dokee39/Aokee-sim/webots/worlds/.balance_infantry_test.jpg

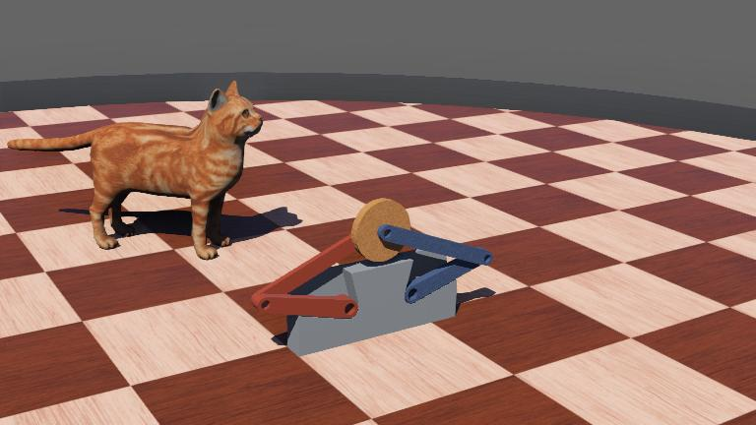
webots/worlds/.balance_infantry_test.jpg
