dokee39/Aokee-sim/webots/worlds/.five_link_sim.jpg

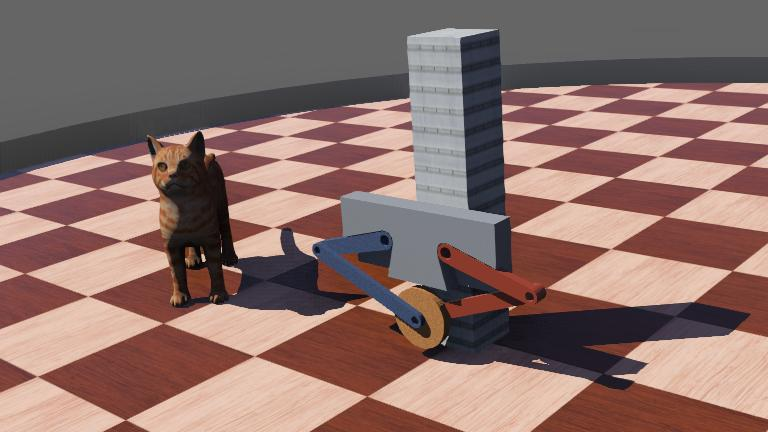
webots/worlds/.five_link_sim.jpg
