dokee39/Aokee-sim/README.md

# Aokee-sim

## 先完成, 再完美
## 先完成, 再完美
## 先完成, 再完美
## 先完成, 再完美
## 先完成, 再完美
## 先完成, 再完美
## 先完成, 再完美
## 先完成, 再完美
## 先完成, 再完美
## 先完成, 再完美
## 先完成, 再完美
## 先完成, 再完美
## 先完成, 再完美
## 先完成, 再完美
## 先完成, 再完美
## 先完成, 再完美
## 先完成, 再完美
## 先完成, 再完美
## 先完成, 再完美
## 先完成, 再完美
## 先完成, 再完美
## 先完成, 再完美
## 先完成, 再完美
## 先完成, 再完美
## 先完成, 再完美
## 先完成, 再完美
## 先完成, 再完美
## 先完成, 再完美
## 先完成, 再完美
## 先完成, 再完美
## 先完成, 再完美
## 先完成, 再完美
## 先完成, 再完美
## 先完成, 再完美
## 先完成, 再完美
## 先完成, 再完美
## 先完成, 再完美
## 先完成, 再完美
## 先完成, 再完美
## 先完成, 再完美
## 先完成, 再完美
## 先完成, 再完美
## 先完成, 再完美
## 先完成, 再完美
## 先完成, 再完美
## 先完成, 再完美
## 先完成, 再完美
## 先完成, 再完美
## 先完成, 再完美
## 先完成, 再完美
## 先完成, 再完美
## 先完成, 再完美
## 先完成, 再完美
## 先完成, 再完美
## 先完成, 再完美
## 先完成, 再完美
## 先完成, 再完美
## 先完成, 再完美
## 先完成, 再完美
