dokee39/Aokee-sim/webots/worlds/.lqr_sim.jpg

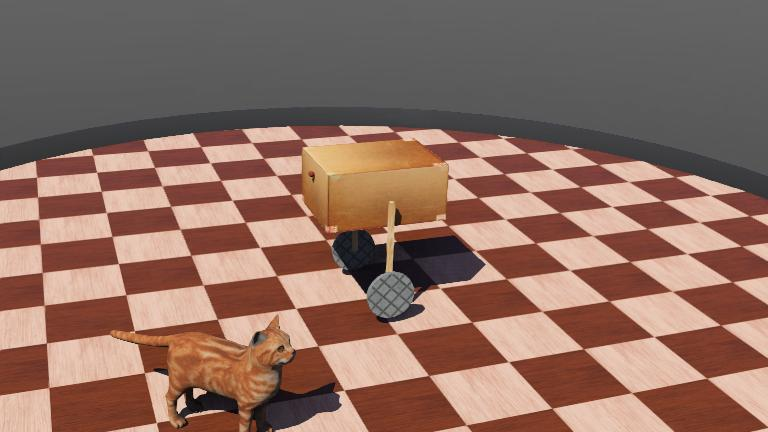
webots/worlds/.lqr_sim.jpg
