dokee39/Aokee-sim/model/Aokee BOM.xlsx

级别 | 零件名称 | 数量 | 总数 | 单价 | 总价 | 已出图 | 已加工/采购
1.1.1.3 | ###__front_rear_end | 2
1.1.1.4 | ###__joint | 2
1.1.3 | ##__bottom | 1
1.1.1 | ##__frame | 1
1.1.2 | ##__leg | 2
1.1.1.4.12 | CNC_A96061__frame_纵竖连接 | 2 | 4 | 17.6 | 70.4 | TRUE | TRUE
1.1.2.17 | CNC_A96061__joint_不带螺纹 | 2 | 4 | 15.6 | 62.4 | FALSE | FALSE
1.1.2.13 | CNC_A96061__joint_带螺纹 | 2 | 4 | 15.6 | 62.4 | TRUE | FALSE
1.1.2.19 | CNC_A96061__wheel_jonit | 1 | 2 | 15.6 | 31.2 | FALSE | FALSE
1.1.1.4.13 | CNC_A96061__关节电机固定1 | 1 | 2 | 25.6 | 51.2 | TRUE | FALSE
1.1.1.4.14 | CNC_A96061__关节电机固定2 | 1 | 2 | 25.6 | 51.2 | TRUE | FALSE
1.1.2.23 | CNC_A96061__轮毂 | 1 | 2 | 54.6 | 109.2 | TRUE | FALSE
1.1.3.5 | CNC_A96061__铝方管与肚兜前板连接件 | 2 | 2 | 15.6 | 31.2 | TRUE | TRUE
1.1.3.7 | CNC_A96061__铝方管与阻尼合页连接件 | 2 | 2 | 15.6 | 31.2 | TRUE | TRUE
1.1.1.3.1 | CNC_A96061__前后挡板连接件 | 2 | 4 | 15.6 | 62.4 | TRUE | FALSE
1.1.1.4.5 | CNC_A96061__碳管管夹座 | 4 | 8 | 15.6 | 124.8 | TRUE | 4
1.1.1.4.1 | CNC_A96061__碳管管夹座 (不带螺纹) | 2 | 4 | 15.6 | 62.4 | TRUE | FALSE
1.1.3.3 | EE_COM__大疆电池 | 1 | 1
1.1.1.4.8 | EE_MOTOR__GO-M8010-6 | 1 | 2 | 490 | 980 |  | FALSE
1.1.2.12 | EE_MOTOR__GO-M8010-6 | 2 | 4 | 490 | 1960 |  | FALSE
1.1.1.3.11 | OTR_COM__弹簧合页 | 1 | 2 | 5.9 | 11.8 |  | TRUE
1.1.1.3.6 | OTR_COM__导轮_6*24*8 | 2 | 4 | 3.6 | 14.4 |  | TRUE
1.1.2.14 | OTR_COM__轮毂包胶 | 1 | 2 |  | 0 |  | FALSE
1.1.1.4.4 | OTR_COM__碳管管夹_20 | 12 | 24 | 4 | 96 |  | TRUE
1.1.3.1 | OTR_COM__阻尼合页 | 2 | 2 | 15 | 30 |  | TRUE
1.1.1.3.13 | PL_C1_盖子 | 1 | 2 |  | 0 | TRUE | FALSE
1.1.2.5 | PL_C10__joint_中间碳板 | 2 | 4 |  | 0 | TRUE | FALSE
1.1.2.22 | PL_C10__leg_lower1 | 1 | 2 |  | 0 | TRUE | FALSE
1.1.2.11 | PL_C10__leg_lower2 | 1 | 2 |  | 0 | TRUE | FALSE
1.1.2.7 | PL_C10__leg_upper1 | 2 | 4 |  | 0 | TRUE | FALSE
1.1.2.4 | PL_C10__wheel_偏移板 | 1 | 2 |  | 0 | TRUE | FALSE
1.1.1.4.11 | PL_C10__关节连接件_10 | 1 | 2 |  | 0 | TRUE | FALSE
1.1.1.4.2 | PL_C10__关节连接件_带限位 | 2 | 4 |  | 0 | TRUE | FALSE
1.1.2.3 | PL_C10__腿部限位连接件 | 1 | 2 |  | 0 | TRUE | FALSE
1.1.2.21 | PL_C2__wheel_joint | 1 | 2 |  | 0 | TRUE | FALSE
1.1.1.3.9 | PL_C2__导轮连接2 | 2 | 4 |  | 0 | TRUE | FALSE
1.1.3.11 | PL_C2__电池魔术贴钩板 | 1 | 1 |  | 0 | TRUE | FALSE
1.1.1.4.9 | PL_C2__关节连接件_2 | 1 | 2 |  | 0 | TRUE | FALSE
1.1.1.3.8 | PL_C3__导轮连接1 | 2 | 4 |  | 0 | TRUE | FALSE
1.1.1.3.14 | PL_C3__导轮转接板 | 2 | 4 |  | 0 | TRUE | FALSE
1.1.3.9 | PL_C3__肚兜侧板 | 2 | 2 |  | 0 | TRUE | FALSE
1.1.3.10 | PL_C3__肚兜底板 | 1 | 1 |  | 0 | TRUE | FALSE
1.1.3.8 | PL_C3__肚兜后板 | 1 | 1 |  | 0 | TRUE | FALSE
1.1.3.14 | PL_C3__肚兜前板 | 1 | 1 |  | 0 | TRUE | FALSE
1.1.1.3.2 | PL_C3__前后挡板 | 1 | 2 |  | 0 | TRUE | FALSE
1.1.1.4.15 | PL_C3__frame_joint_outer | 1 | 2 |  | 0 | TRUE | FALSE
1.1.2.8 | PL_C4__wheel_连接电机 | 1 | 2 |  | 0 | TRUE | FALSE
1.1.2.18 | PL_C4__wheel_连接轮毂 | 1 | 2 |  | 0 | TRUE | FALSE
1.1.1.3.16 | PL_C4__前后载板 | 1 | 2 |  | 0 | TRUE | FALSE
1.1.1.4.10 | PL_C5__frame_joint_inner | 1 | 2 |  | 0 | TRUE | FALSE
1.1.1.4.16 | PP_A3020_1__frame_joint_纵 | 1 | 2 |  | 0 | TRUE | FALSE
1.1.1.4.3 | PP_A3020_1_frame_joint_竖 | 2 | 4 |  | 0 | TRUE | FALSE
1.1.1.1 | PP_C20_1__碳纤维管 | 2 | 4 |  | 0 |  | FALSE
1.1.3.13 | PR_FDM_PLA__RFID连接件 | 1 | 1 |  | 0 | TRUE | TRUE
1.1.2.1 | PR_FDM_PLA__wheel_补差价垫板 | 1 | 2 |  | 0 | TRUE | TRUE
1.1.3.6 | PR_FDM_PLA__肚兜前板固定孔打印件 | 2 | 2 |  | 0 | TRUE | TRUE
1.1.1.3.15 | PR_FDM_PLA_装甲板底垫板 | 2 | 4 |  | 0 | TRUE | TRUE
1.1.1.4.6 | PR_FDM_PLA__板与纵铝方管间支撑件 | 3 | 6 |  | 0 | TRUE | TRUE
1.1.1.4.7 | PR_FDM_TPU__关节限位软块 | 2 | 4 |  | 0 | TRUE | FALSE
1.1.2.10 | PR_FDM_TPU__腿部限位柔性打印件 | 1 | 2 |  | 0 | TRUE | FALSE
1.1.2.9 | PR_FDM_TPU__蓄油环_joint | 2 | 4 |  | 0 | TRUE | FALSE
1.1.2.15 | PR_FDM_TPU__蓄油环_wheel | 1 | 2 |  | 0 | TRUE | FALSE
1.1.3.5.20 | PR_FDM_PLA__铝方管补强件1 | 1 | 2 |  | 0 | TRUE | TRUE
1.1.3.5.2 | PR_FDM_PLA__铝方管补强件2 | 4 | 8 |  | 0 | TRUE | TRUE
1.1.3.4 | PR_FDM_PLA__铝方管补强件3_1_带钩子 | 1 | 1 |  | 0 | TRUE | TRUE
1.1.3.6 | PR_FDM_PLA__铝方管补强件3_2_带钩子 | 1 | 1 |  | 0 | TRUE | TRUE
1.1.3.5.17 | PR_FDM_PLA__铝方管补强件4 | 1 | 2 |  | 0 | TRUE | TRUE
1.1.3.5.19 | PR_FDM_PLA__铝方管补强件5 | 2 | 4 |  | 0 | TRUE | TRUE
1.1.3.12 | RM__场地交互模块_FI02_2020 | 1 | 1 |  | 0
1.1.1.2 | RM__灯条模块_LI01_2020 | 1 | 2 |  | 0
1.1.3.4 | RM__电源模块_PM02_2020 | 1 | 1 |  | 0
1.1.1.3.12 | RM__装甲模块_AM12_2020 | 1 | 2 |  | 0
1.1.1.3.10 | RM__装甲支撑架A型_2020 | 2 | 4 |  | 0
1.1.2.6 | STD_BEAR__AXK2542_推力滚针_25*42*4 | 2 | 4 | 3 | 12 |  | TRUE
1.1.2.2 | STD_BEAR__AXK3552_推力滚针_35*52*4 | 1 | 2 | 2 | 4 |  | TRUE
1.1.2.20 | STD_BEAR__F6805ZZ_法兰_25*37*7 | 2 | 4 | 10 | 40 |  | TRUE
1.1.2.16 | STD_BEAR__F6806ZZ_法兰_30*42*7 | 1 | 2 | 6 | 12 |  | TRUE
1.1.1.3.5 | STD_COM__铝方条直角转接件_M4*16-H10*34 | 8 | 8 | 5.5 | 44 |  | TRUE
1.1.3.2 | STD_COM__铝方条直角转接件_M4*16-H10*34 | 4 | 8 | 5.5 | 44 |  | TRUE
1.1.1.3.4 | STD_FAST__垫圈_M6*10*1 | 4 | 8 |  | 0 |  | TRUE
1.1.1.3.7 | 六角螺母 DIN 934 - M5 x 0.8 钢 6 平垫圈 | 2 | 4 |  | 0 |  | TRUE
1.1.1.3.3 | 内六角头轴肩螺钉 ISO 7379 - 6 x 12 钢 4.6 平垫圈 | 2 | 4 |  | 0 |  | TRUE
