dokee39/Aokee-sim/motor/motor.xlsx

型号 | 额定扭矩 | 峰值扭矩 | 额定转速 | 峰值转速 | 额定电流 | 堵转电流 | 重量 | 减速比 | 齿轮类型 | 尺寸 | 价格 | 备注
SteadyWin GIM8108-8 | 7.5 | 22 | 110 | 320 | 7 | 25 | 396 | 8:1 | 金属 | 92x(24+11) | 599
SteadyWin GIM6108-8 | 5 | 11 | 120 | 420 | 10.5 | 25 | 388 | 8:1 | 金属 | 80x(26+10.5) | 449
小米 CyberGear | 4 | 12 | 240 | 296 | 6.5 | 23 | 317 | 7.75:1 | 塑料 | 80 | 549
本末 M1505B_111 | 3 | 9.5 | 360 | 510 | 7 | 30 | 1540 | 1:1 | - | 180x33 | 1200
瓴控 MF9025 V2 (16T) | 2.42 | 4.5 | 490 | 710 | 7.45 | 40 | 963 | 1:1 | - | 89x53 | 990
DJI M3508 减速箱改 | 2.46 | 3.69 | 571 | 587 | 10 | 2.5 | 336 | 268:17 | 金属 | 80x60 | 399
DJI M3508 | 3 | 4.5 | 469 | 482 | 10 | 2.5 | 365 | 3591:187 | 金属 | 42x67 | 0
小米铁蛋狗一代电机 |  | 32 |  | 220 |  | 40 | 560 |  |  | 93x54 | 300
Unitree GO-M8010-6 |  | 23.7 |  | 300 |  | 40 | 530 | 6.33:1 |  | 96x42 | 490
