dokee39/Aokee-sim/model/发加工/CNC/CNC_A96061__joint_不带螺纹.step

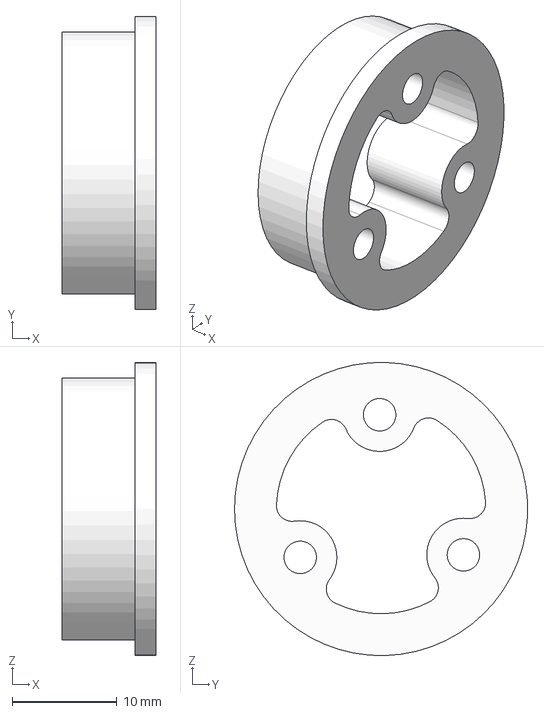
[picture p4: CAD file, 2024-09-26]
model/发加工/CNC/CNC_A96061__joint_不带螺纹.step
9.00 x 28.0 x 28.0 mm
