dokee39/Aokee-sim/model/发加工/PL/PL_C2__关节连接件_2_厚度2_数量2.dxf

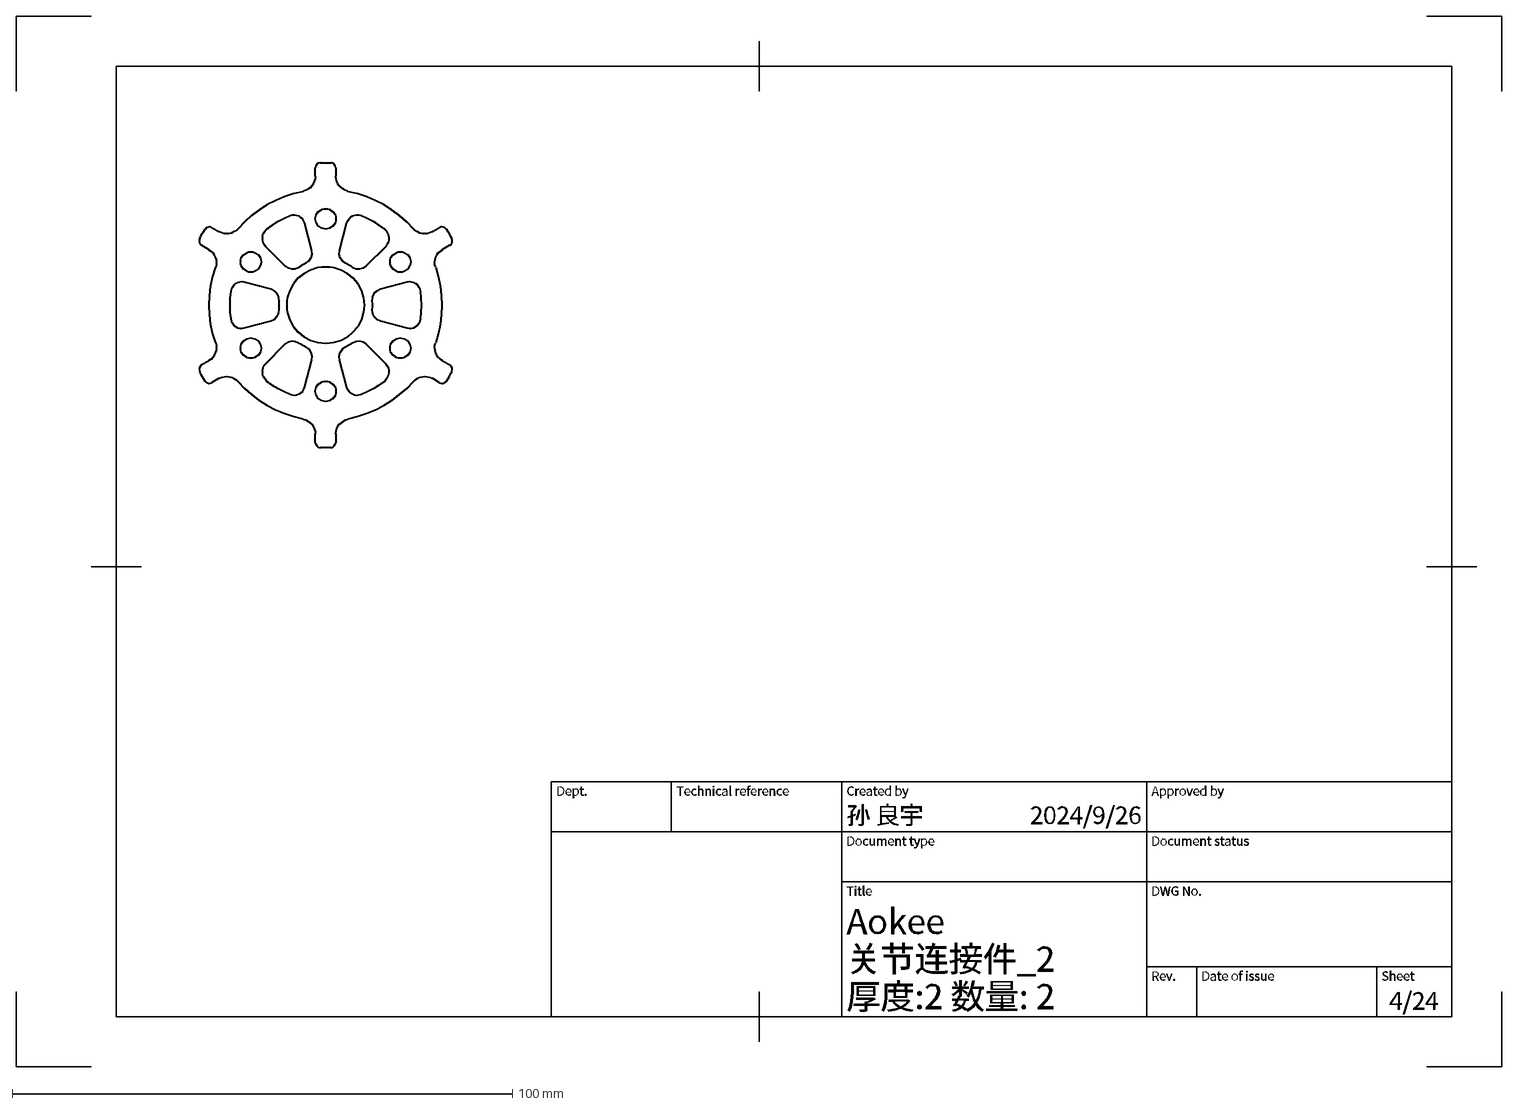
[picture p5: CAD file, 2024-09-26]
model/发加工/PL/PL_C2__关节连接件_2_厚度2_数量2.dxf
厚度:2 数量: 2
2024/9/26
4/24
关节连接件_2
Aokee
孙 良宇
Dept.
Technical reference
Created by
Approved by
Document type
Document status
Title
DWG No.
Rev.
Date of issue
Sheet
