dokee39/Aokee-sim/model/发加工/PP/PP_A3020_1__frame_joint_竖.step

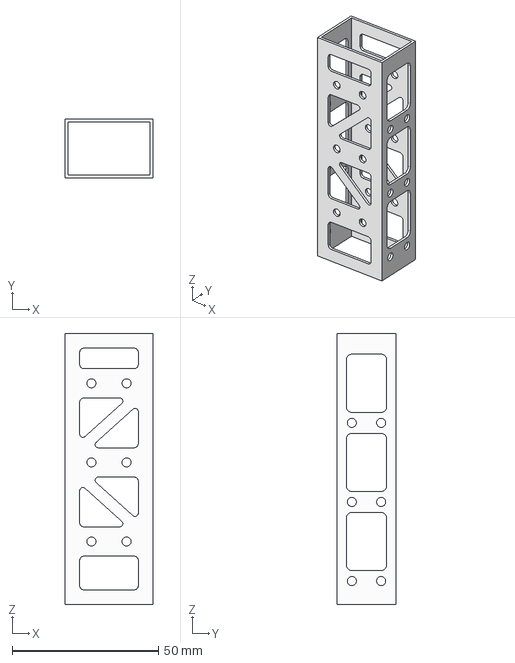
[picture p6: CAD file, 2024-09-26]
model/发加工/PP/PP_A3020_1__frame_joint_竖.step
30.0 x 20.0 x 92.5 mm
