dokee39/Aokee-sim/model/发加工/PR/PR_FDM_PLA__铝方管补强件3_带钩子_2.step

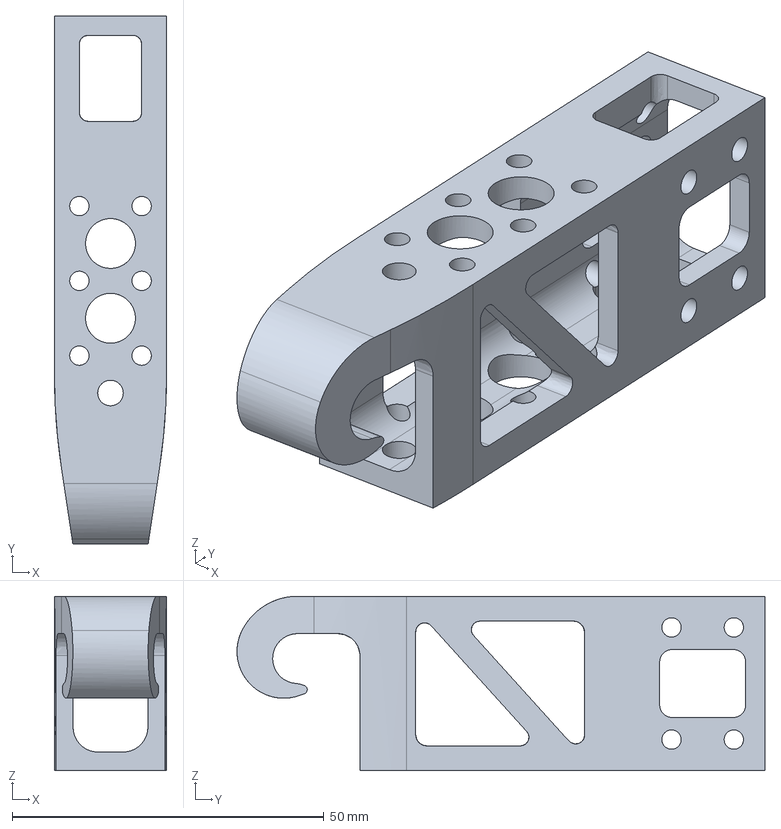
[picture p7: CAD file, 2024-10-07]
model/发加工/PR/PR_FDM_PLA__铝方管补强件3_带钩子_2.step
18.0 x 84.7 x 28.0 mm
