dokee39/Aokee-sim/webots/meshes/leg_low_1.STL

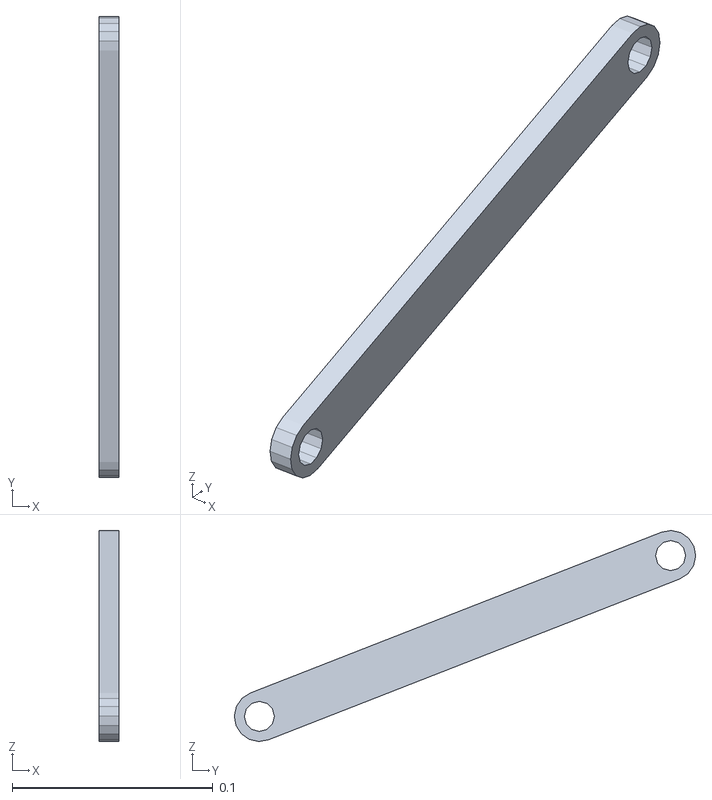
[picture p8: CAD file, 2024-09-06]
webots/meshes/leg_low_1.STL
0.01 x 0.23 x 0.105
