dokee39/Aokee-sim/model/发加工/CNC/CNC_A96061__关节电机固定2.step

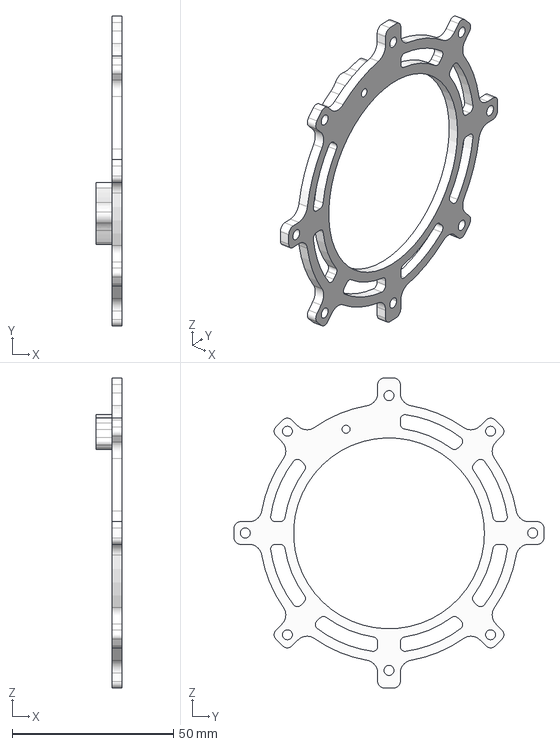
[picture p9: CAD file, 2024-09-26]
model/发加工/CNC/CNC_A96061__关节电机固定2.step
8.00 x 96.0 x 96.0 mm
