dokee39/Aokee-sim/model/发加工/PP/PP_A3020_1__frame_joint_纵.step

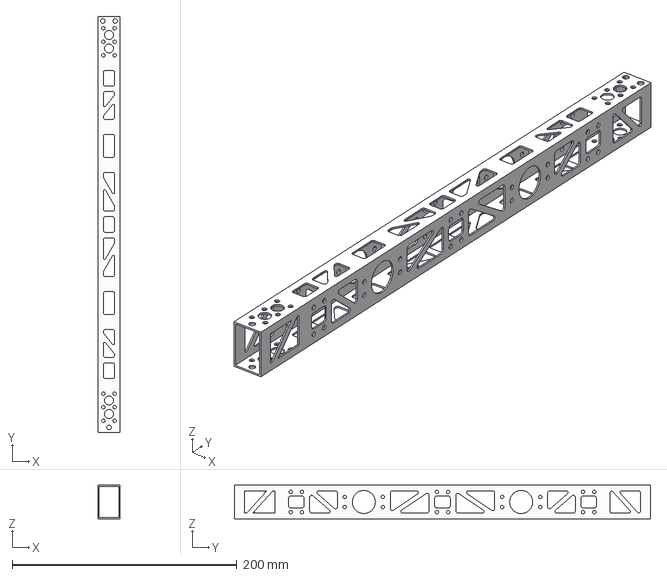
[picture p11: CAD file, 2024-09-26]
model/发加工/PP/PP_A3020_1__frame_joint_纵.step
20.0 x 370.0 x 30.0 mm
