dokee39/Aokee-sim/webots/meshes/wheel1.STL

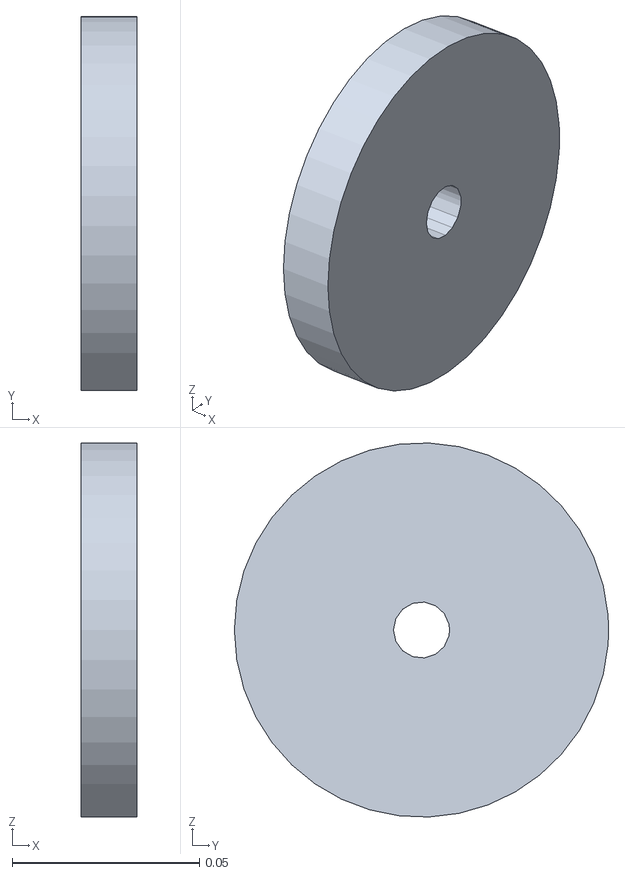
[picture p12: CAD file, 2024-09-06]
webots/meshes/wheel1.STL
0.015 x 0.1 x 0.0999
