dokee39/Aokee-sim/model/发加工/PL/PL_C2__电池魔术贴钩板_厚度2_数量1.dxf

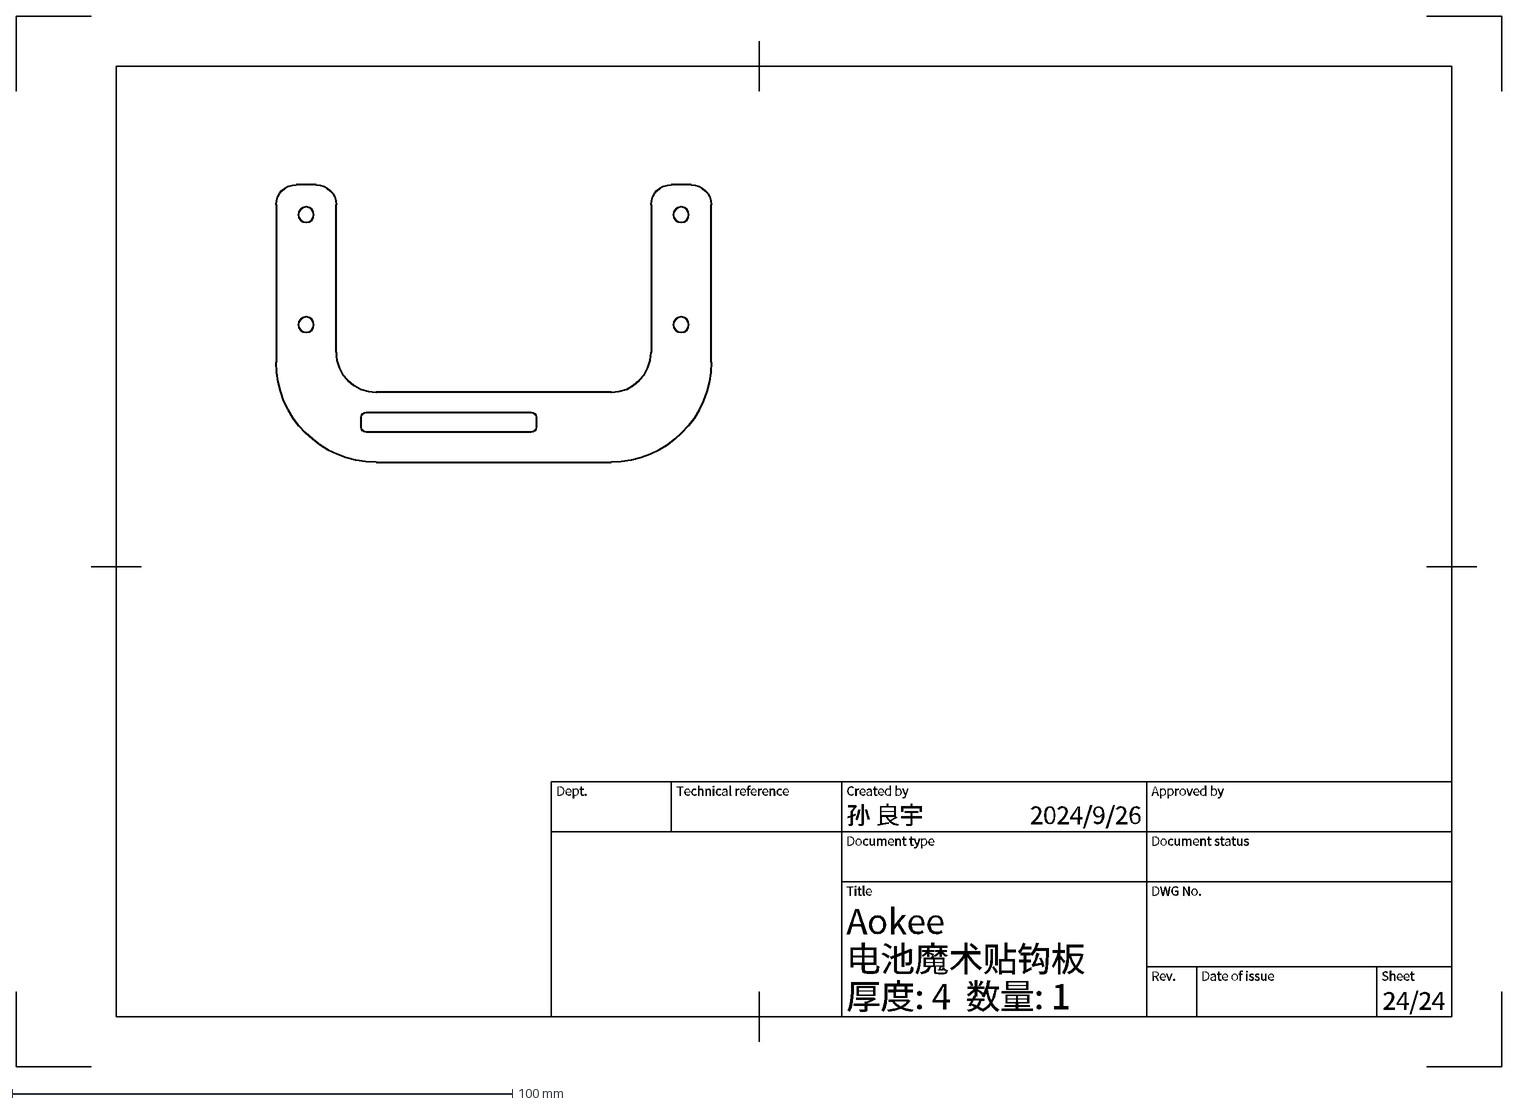
[picture p13: CAD file, 2024-09-26]
model/发加工/PL/PL_C2__电池魔术贴钩板_厚度2_数量1.dxf
厚度: 4 数量: 1
2024/9/26
24/24
电池魔术贴钩板
Aokee
孙 良宇
Dept.
Technical reference
Created by
Approved by
Document type
Document status
Title
DWG No.
Rev.
Date of issue
Sheet
