dokee39/Aokee-sim/model/发加工/PR/PR_FDM_TPU__腿部限位柔性打印件.step

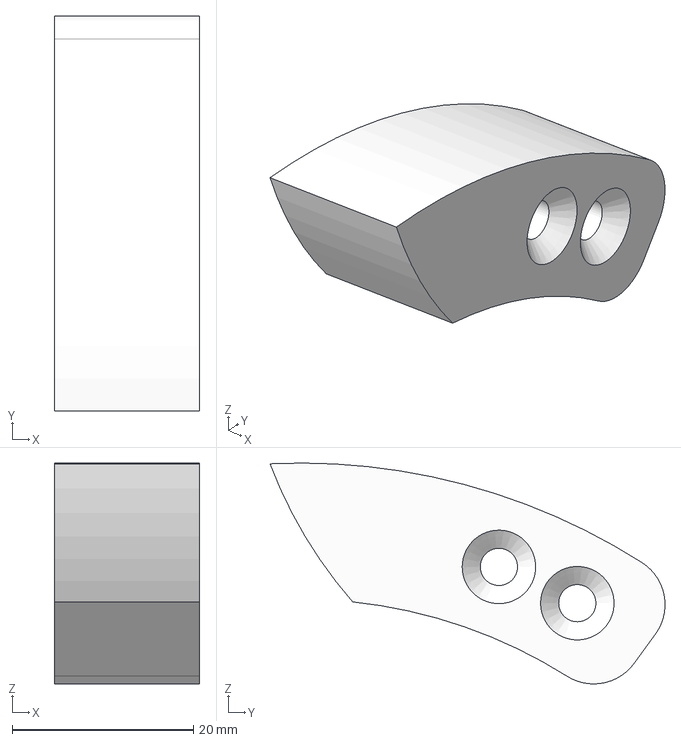
[picture p14: CAD file, 2024-09-26]
model/发加工/PR/PR_FDM_TPU__腿部限位柔性打印件.step
16.0 x 43.5 x 24.3 mm
