dokee39/Aokee-sim/model/发加工/CNC/CNC_A96061__wheel_jonit_加工修改ver.step

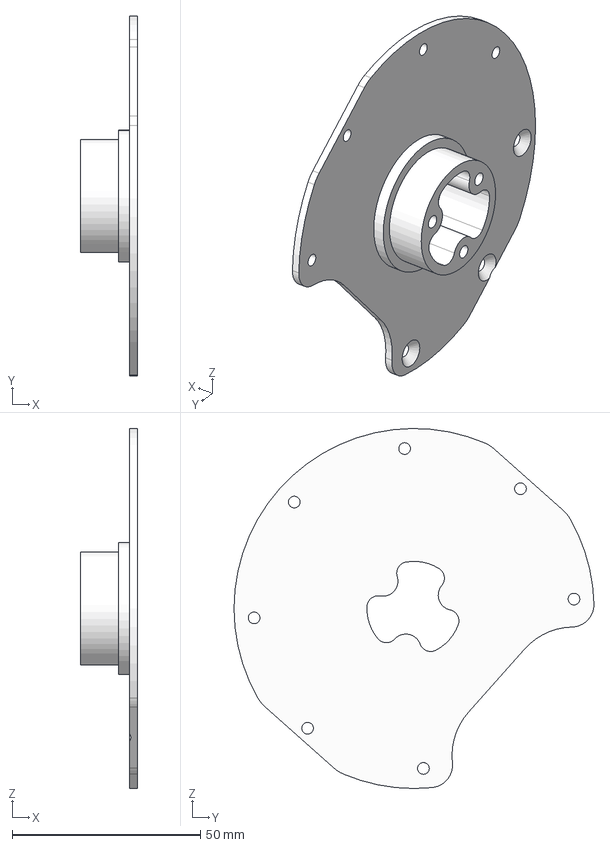
[picture p15: CAD file, 2024-09-26]
model/发加工/CNC/CNC_A96061__wheel_jonit_加工修改ver.step
15.0 x 95.5 x 95.5 mm
