dokee39/Aokee-sim/model/发加工/PL/PL_C2__导轮连接2_厚度2_数量4.dxf

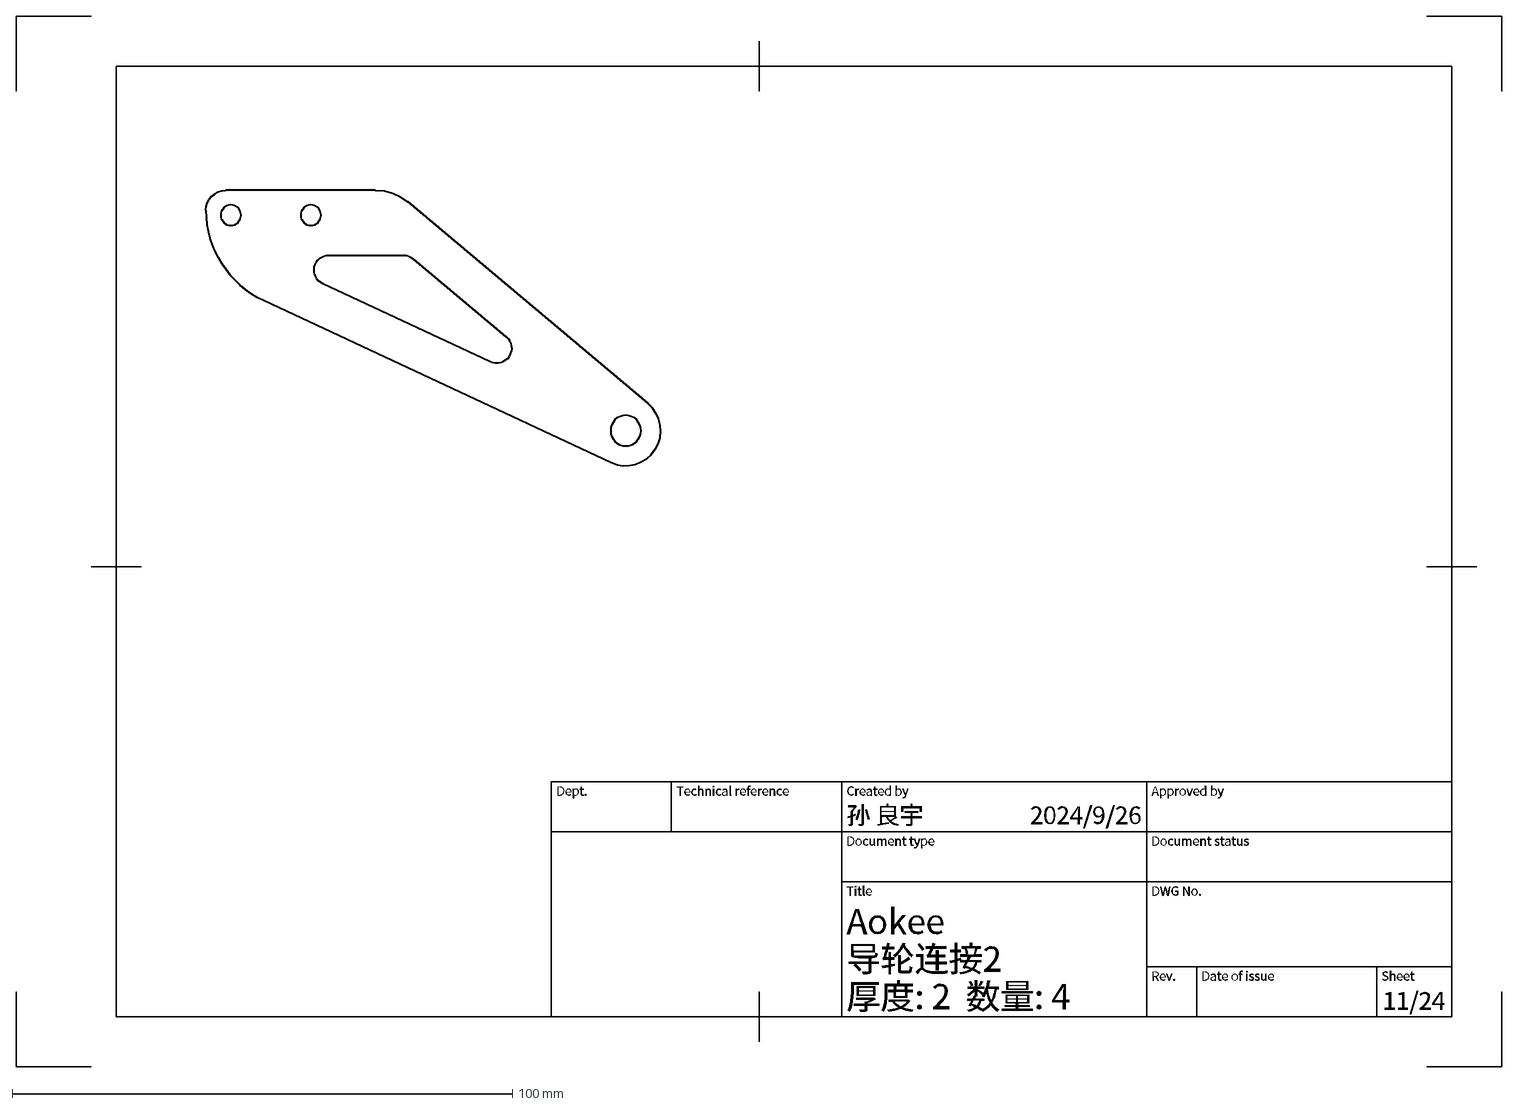
[picture p16: CAD file, 2024-09-26]
model/发加工/PL/PL_C2__导轮连接2_厚度2_数量4.dxf
厚度: 2 数量: 4
2024/9/26
11/24
导轮连接2
Aokee
孙 良宇
Dept.
Technical reference
Created by
Approved by
Document type
Document status
Title
DWG No.
Rev.
Date of issue
Sheet
