dokee39/Aokee-sim/webots/meshes/leg_up_2.STL

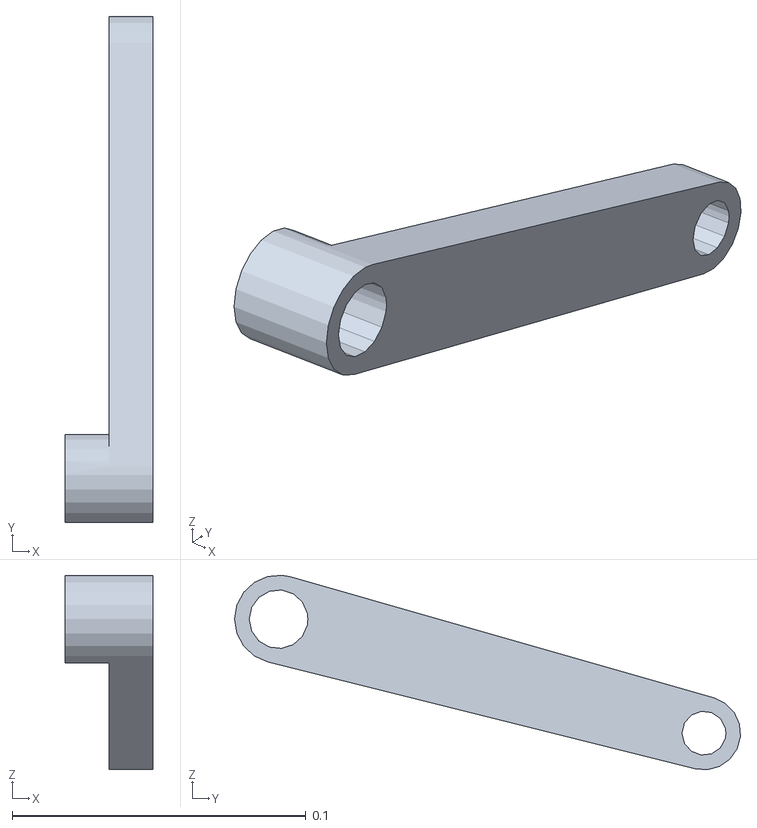
[picture p17: CAD file, 2024-09-06]
webots/meshes/leg_up_2.STL
0.03 x 0.172 x 0.0662
