dokee39/Aokee-sim/model/发加工/CNC/CNC_A96061__frame_纵竖连接.step

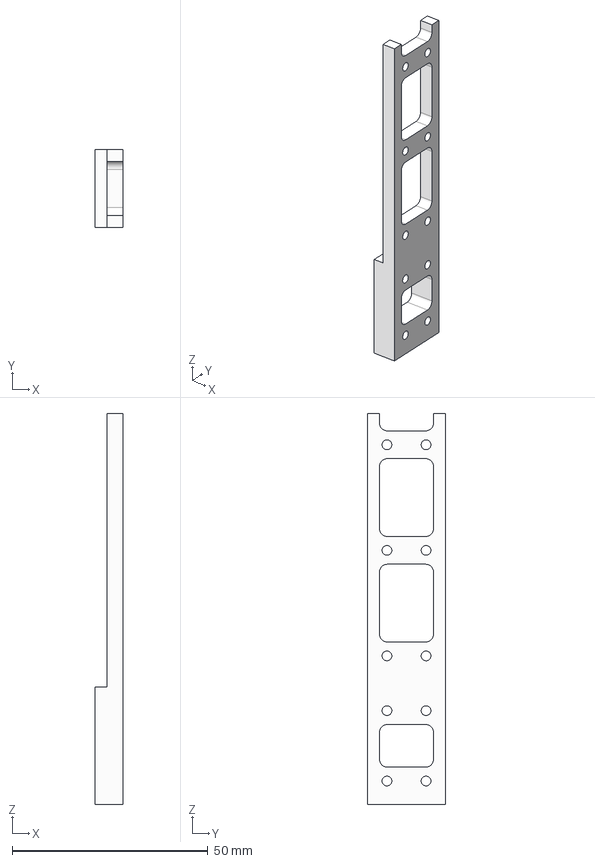
[picture p18: CAD file, 2024-09-26]
model/发加工/CNC/CNC_A96061__frame_纵竖连接.step
7.10 x 20.0 x 100.0 mm
