dokee39/Aokee-sim/model/发加工/PL/PL_C3__肚兜底板_厚度3_数量1.dxf

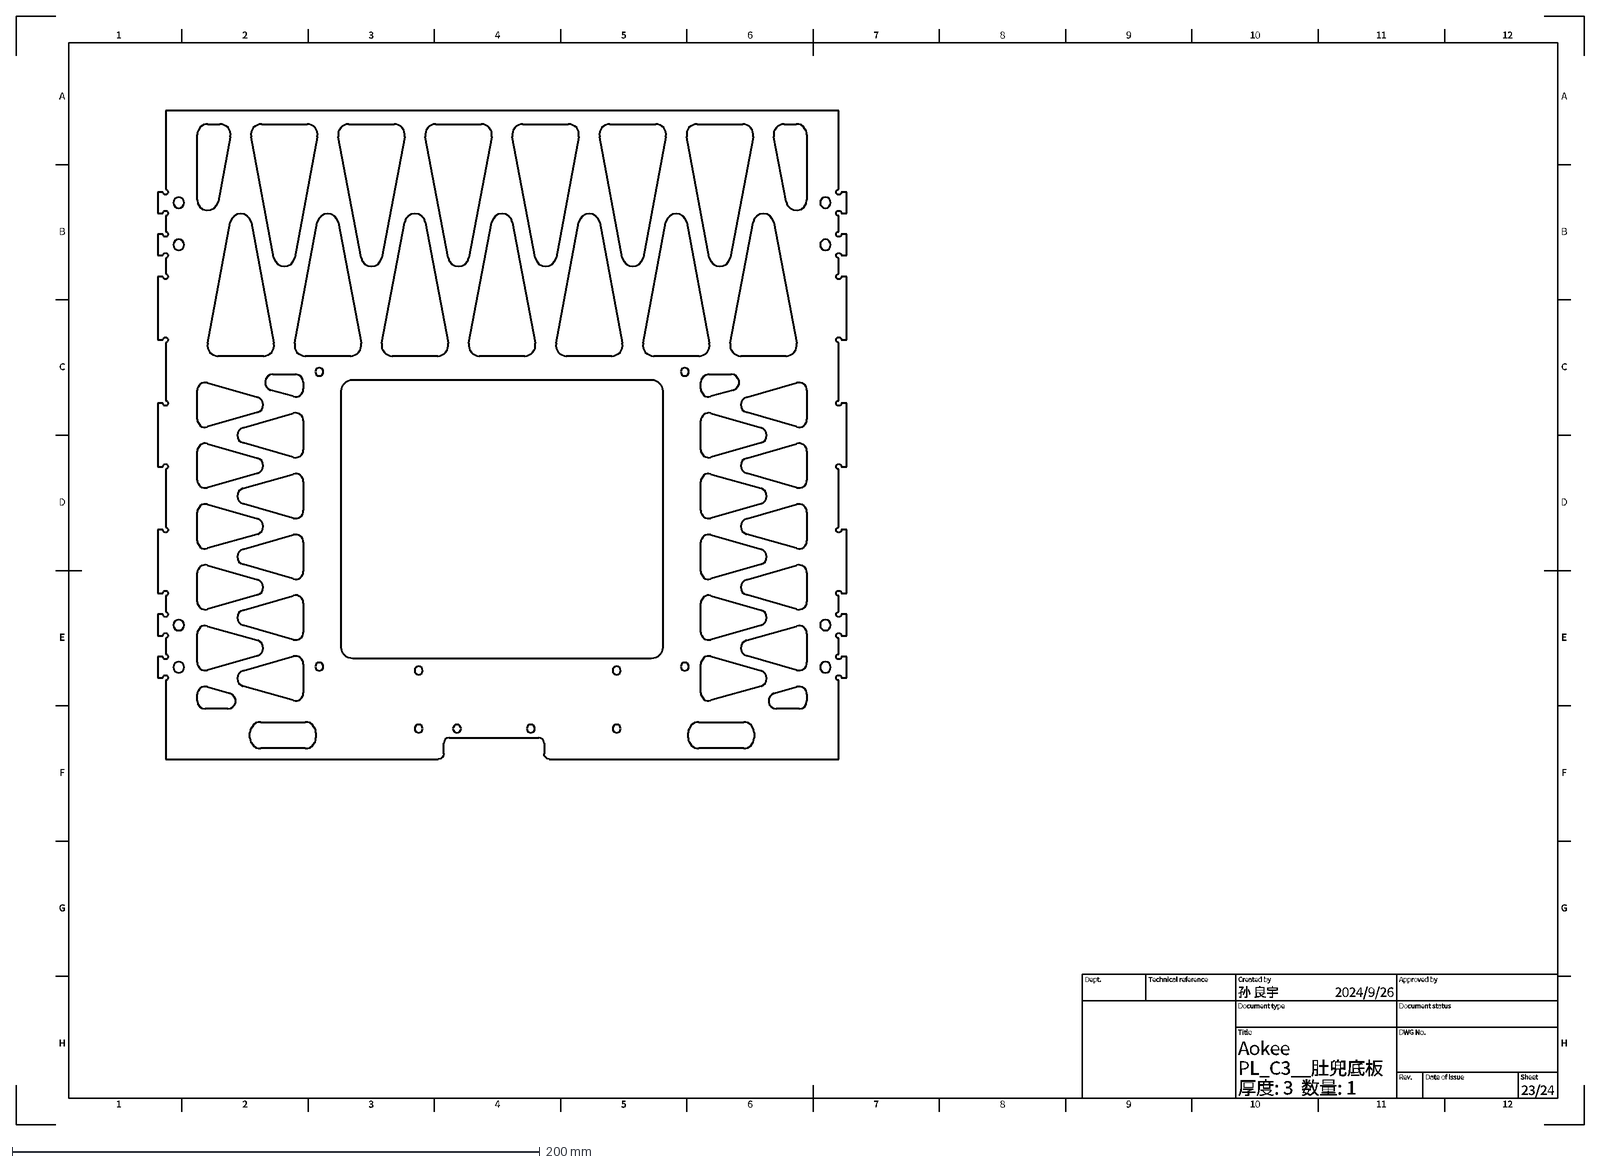
[picture p19: CAD file, 2024-09-26]
model/发加工/PL/PL_C3__肚兜底板_厚度3_数量1.dxf
厚度: 3 数量: 1
2024/9/26
23/24
PL_C3__肚兜底板
Aokee
孙 良宇
Dept.
Technical reference
Created by
Approved by
Document type
Document status
Title
DWG No.
Rev.
Date of issue
Sheet
2
1
3
4
5
6
7
8
9
10
11
12
B
A
C
D
E
F
G
H
