dokee39/Aokee-sim/model/发加工/PL/PL_C3__导轮连接1_厚度3_数量4.dxf

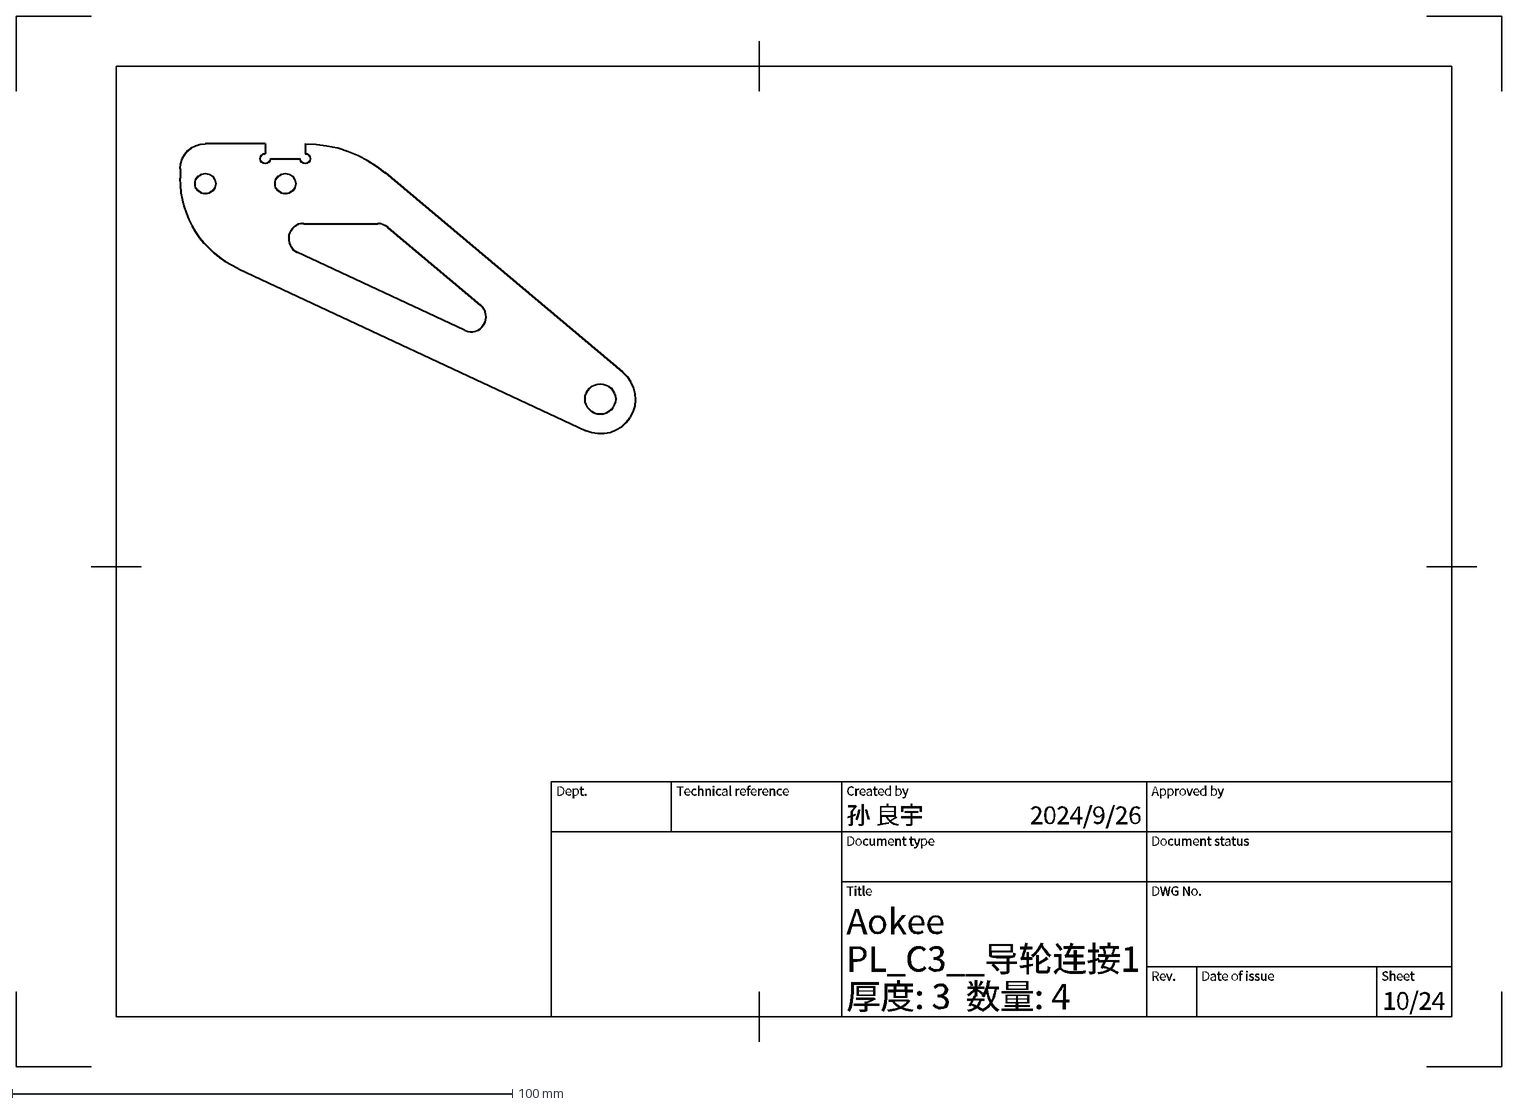
[picture p22: CAD file, 2024-09-26]
model/发加工/PL/PL_C3__导轮连接1_厚度3_数量4.dxf
厚度: 3 数量: 4
2024/9/26
10/24
PL_C3__导轮连接1
Aokee
孙 良宇
Dept.
Technical reference
Created by
Approved by
Document type
Document status
Title
DWG No.
Rev.
Date of issue
Sheet
