dokee39/Aokee-sim/model/发加工/PR/PR_FDM_PLA__装甲板底垫板.step

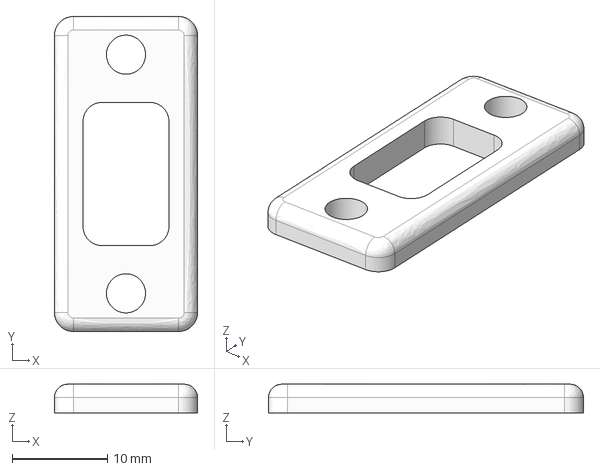
[picture p23: CAD file, 2024-09-26]
model/发加工/PR/PR_FDM_PLA__装甲板底垫板.step
15.0 x 33.0 x 3.00 mm
