dokee39/Aokee-sim/webots/meshes/base_link.STL

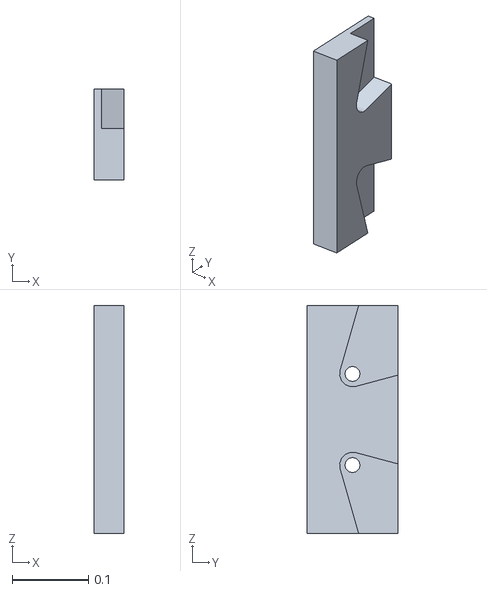
[picture p24: CAD file, 2024-09-06]
webots/meshes/base_link.STL
0.04 x 0.12 x 0.3
