dokee39/Aokee-sim/model/发加工/CNC/CNC_A96061__轮毂.step

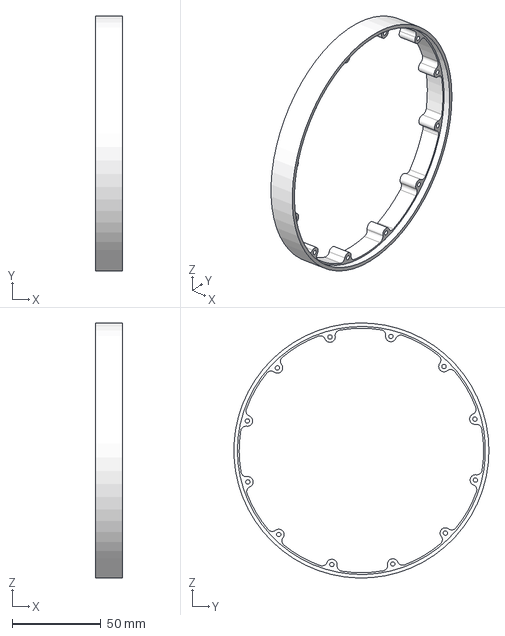
[picture p25: CAD file, 2024-09-26]
model/发加工/CNC/CNC_A96061__轮毂.step
15.0 x 143.9 x 143.9 mm
