dokee39/Aokee-sim/model/发加工/PL/PL_C3__肚兜前板_厚度3_数量1.dxf

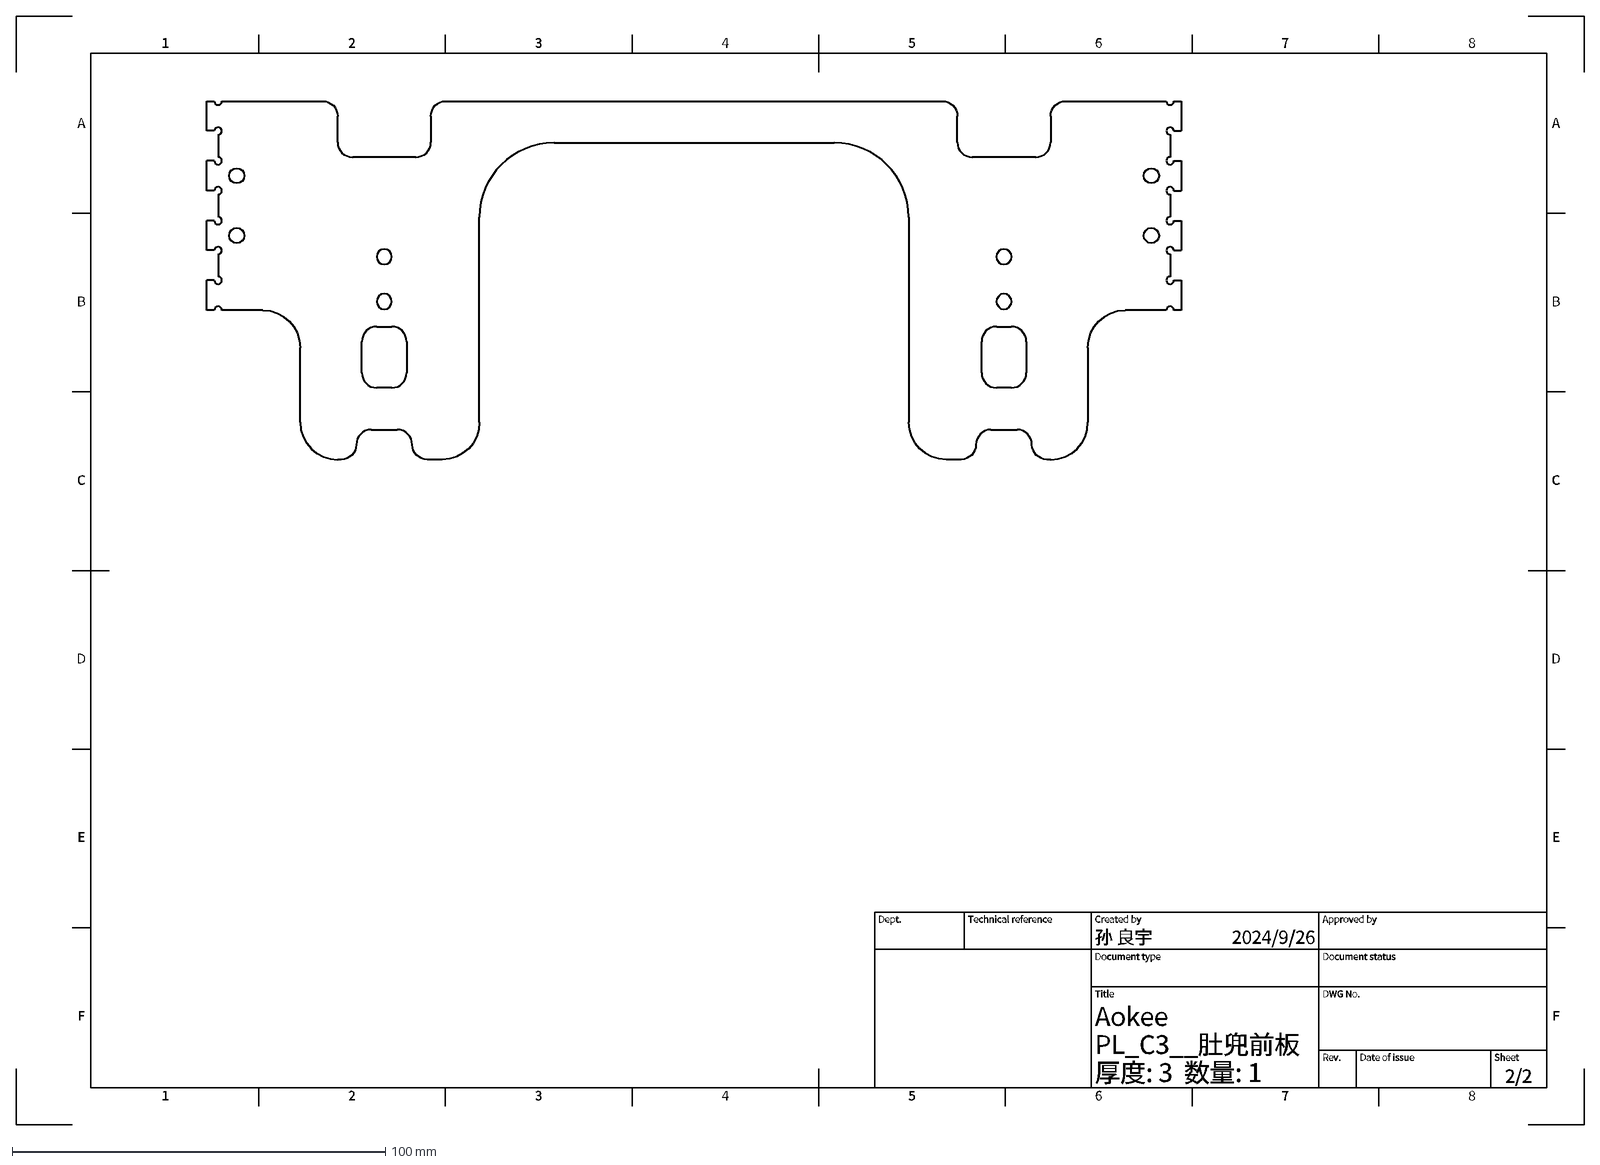
[picture p26: CAD file, 2024-09-26]
model/发加工/PL/PL_C3__肚兜前板_厚度3_数量1.dxf
1
A
2
3
4
5
6
7
8
B
C
D
E
F
厚度: 3 数量: 1
2024/9/26
2/2
PL_C3__肚兜前板
Aokee
孙 良宇
Dept.
Technical reference
Created by
Approved by
Document type
Document status
Title
DWG No.
Rev.
Date of issue
Sheet
