dokee39/Aokee-sim/model/发加工/PR/PR_FDM_PLA__铝方管补强件5.step

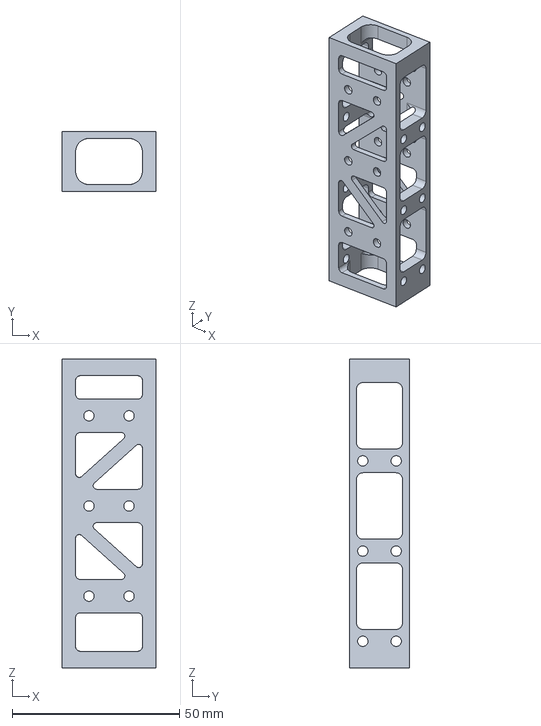
[picture p27: CAD file, 2024-09-26]
model/发加工/PR/PR_FDM_PLA__铝方管补强件5.step
28.0 x 18.0 x 92.5 mm
