dokee39/Aokee-sim/model/发加工/PL/PL_C4__wheel_连接电机_厚度4_数量2.dxf

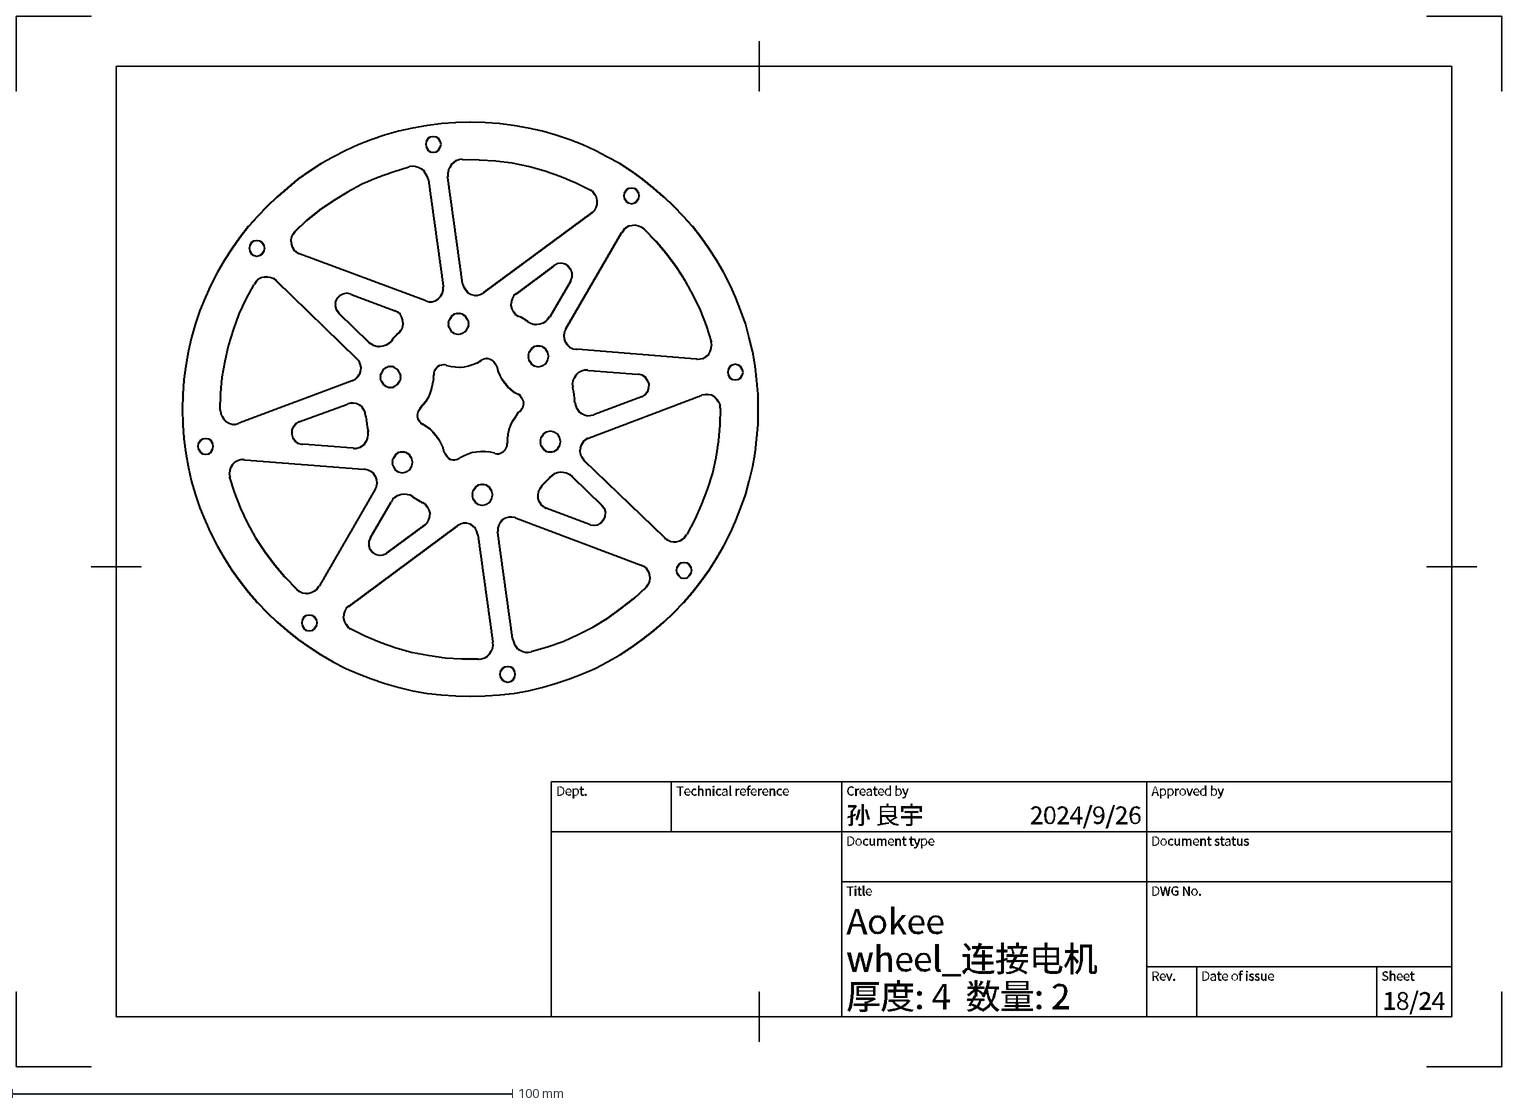
[picture p29: CAD file, 2024-09-26]
model/发加工/PL/PL_C4__wheel_连接电机_厚度4_数量2.dxf
厚度: 4 数量: 2
2024/9/26
18/24
wheel_连接电机
Aokee
孙 良宇
Dept.
Technical reference
Created by
Approved by
Document type
Document status
Title
DWG No.
Rev.
Date of issue
Sheet
