dokee39/Aokee-sim/model/发加工/PR/PR_FDM_TPU__蓄油环_joint.step

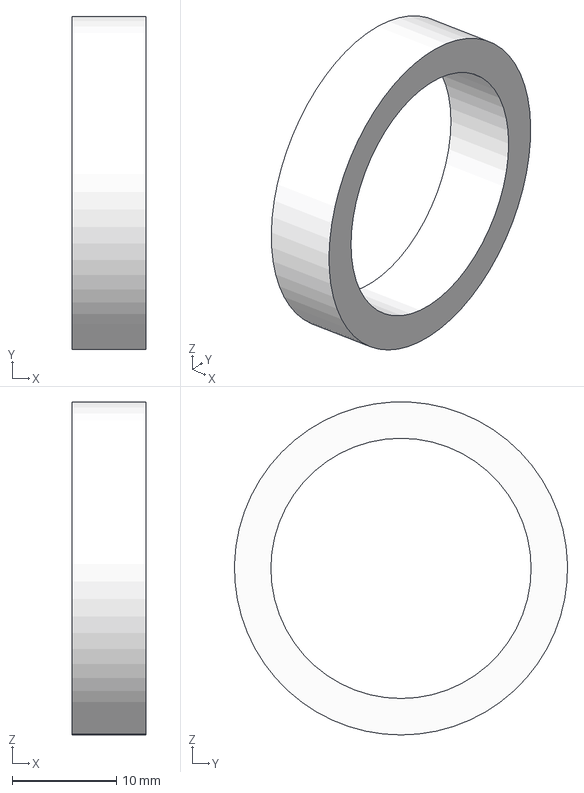
[picture p30: CAD file, 2024-09-26]
model/发加工/PR/PR_FDM_TPU__蓄油环_joint.step
7.15 x 32.0 x 32.0 mm
