dokee39/Aokee-sim/model/发加工/CNC/CNC_A96061__前后挡板连接件.step

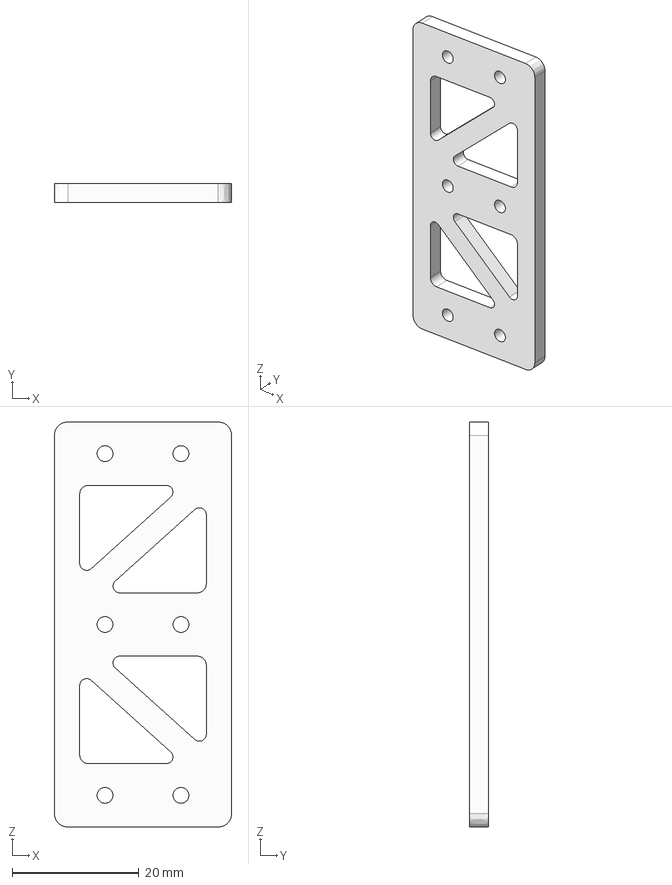
[picture p31: CAD file, 2024-09-26]
model/发加工/CNC/CNC_A96061__前后挡板连接件.step
28.0 x 3.00 x 64.0 mm
