dokee39/Aokee-sim/model/发加工/PR/PR_FDM_TPU__蓄油环_wheel.step

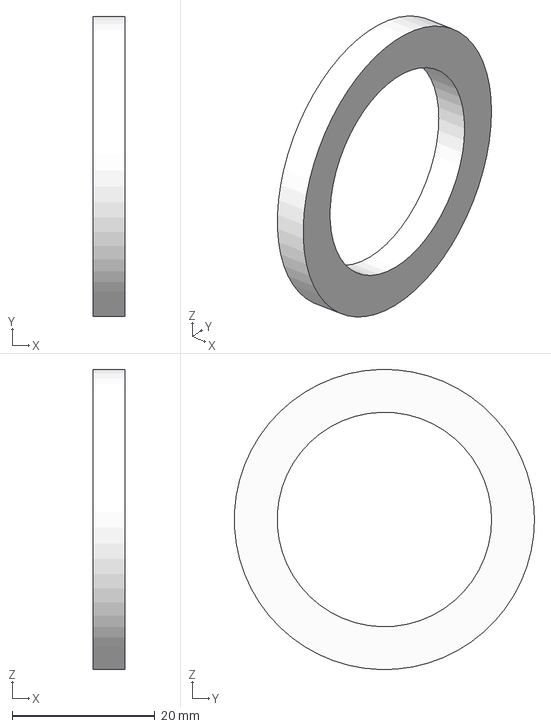
[picture p33: CAD file, 2024-09-26]
model/发加工/PR/PR_FDM_TPU__蓄油环_wheel.step
4.50 x 42.0 x 42.0 mm
