dokee39/Aokee-sim/model/发加工/CNC/CNC_A96061__碳管管夹座.step

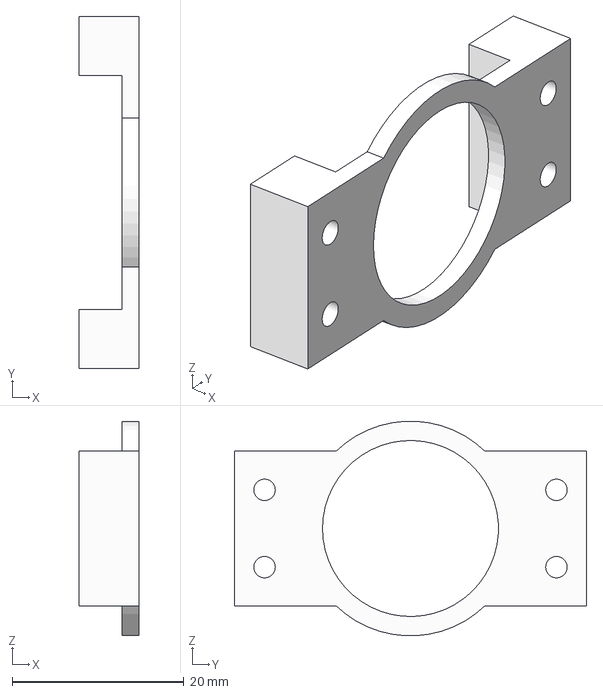
[picture p34: CAD file, 2024-09-26]
model/发加工/CNC/CNC_A96061__碳管管夹座.step
7.00 x 41.0 x 25.0 mm
