dokee39/Aokee-sim/model/发加工/CNC/CNC_A96061__铝方管与肚兜前板连接件.step

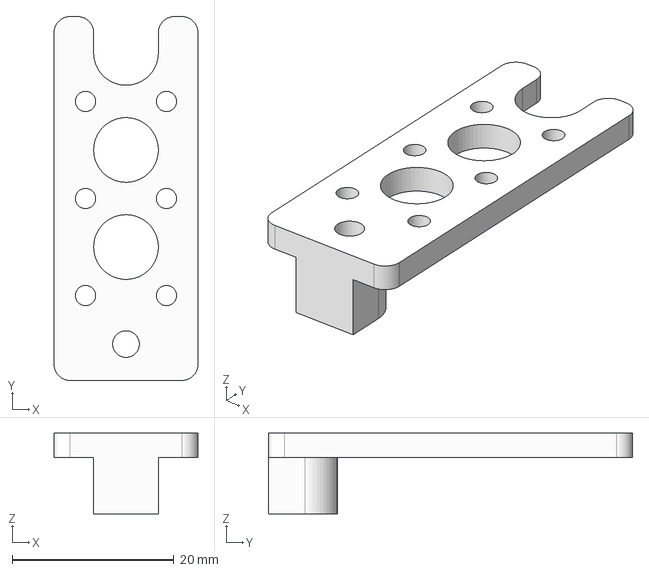
[picture p37: CAD file, 2024-09-26]
model/发加工/CNC/CNC_A96061__铝方管与肚兜前板连接件.step
17.8 x 45.0 x 10.0 mm
