dokee39/Aokee-sim/model/发加工/PR/PR_FDM_PLA__肚兜前板固定孔打印件.step

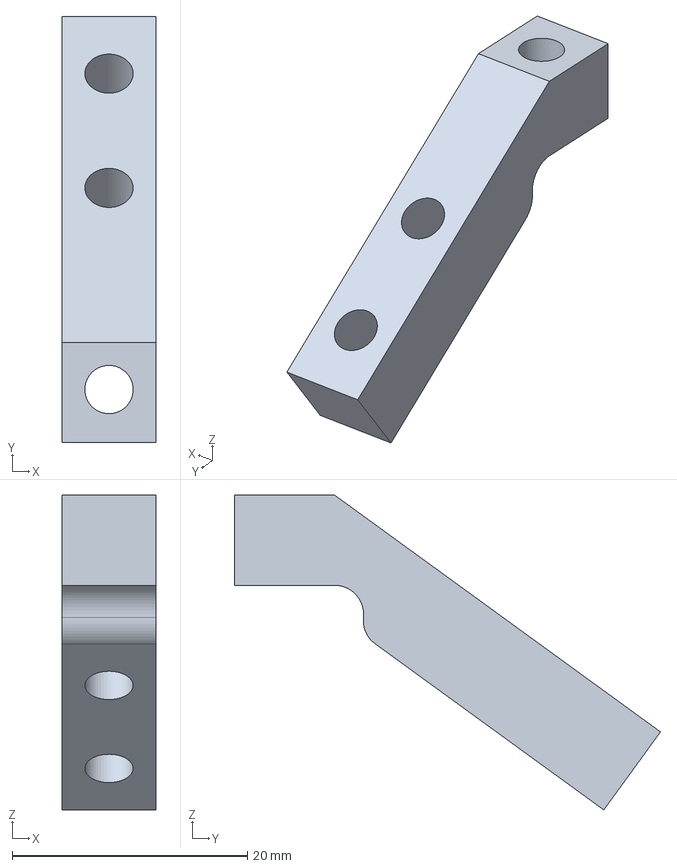
[picture p39: CAD file, 2024-09-26]
model/发加工/PR/PR_FDM_PLA__肚兜前板固定孔打印件.step
8.00 x 36.2 x 26.7 mm
