dokee39/Aokee-sim/model/发加工/PR/PR_FDM_PLA__板与纵铝方管间支撑件.step

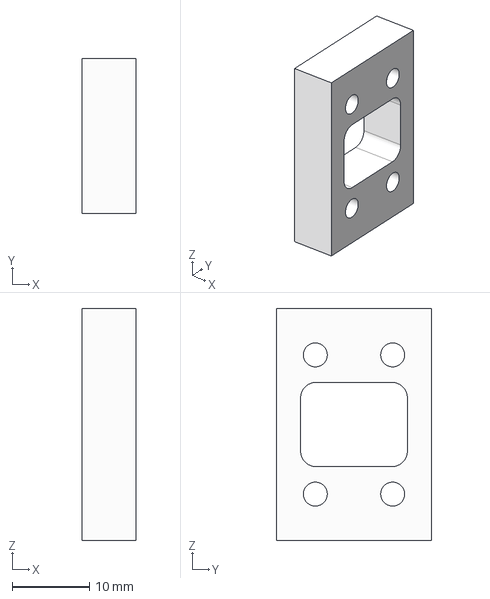
[picture p42: CAD file, 2024-09-26]
model/发加工/PR/PR_FDM_PLA__板与纵铝方管间支撑件.step
7.00 x 20.0 x 30.0 mm
