dokee39/Aokee-sim/model/发加工/PR/PR_FDM_PLA__RFID连接件.step

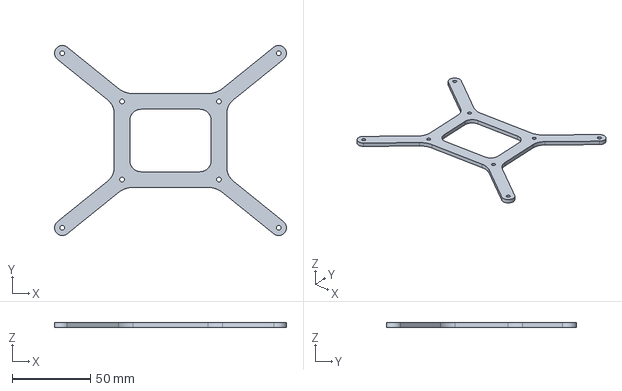
[picture p44: CAD file, 2024-09-26]
model/发加工/PR/PR_FDM_PLA__RFID连接件.step
148.5 x 121.7 x 3.00 mm
