dokee39/Aokee-sim/model/发加工/PL/PL_C10__关节连接件_10_厚度10_数量2.dxf

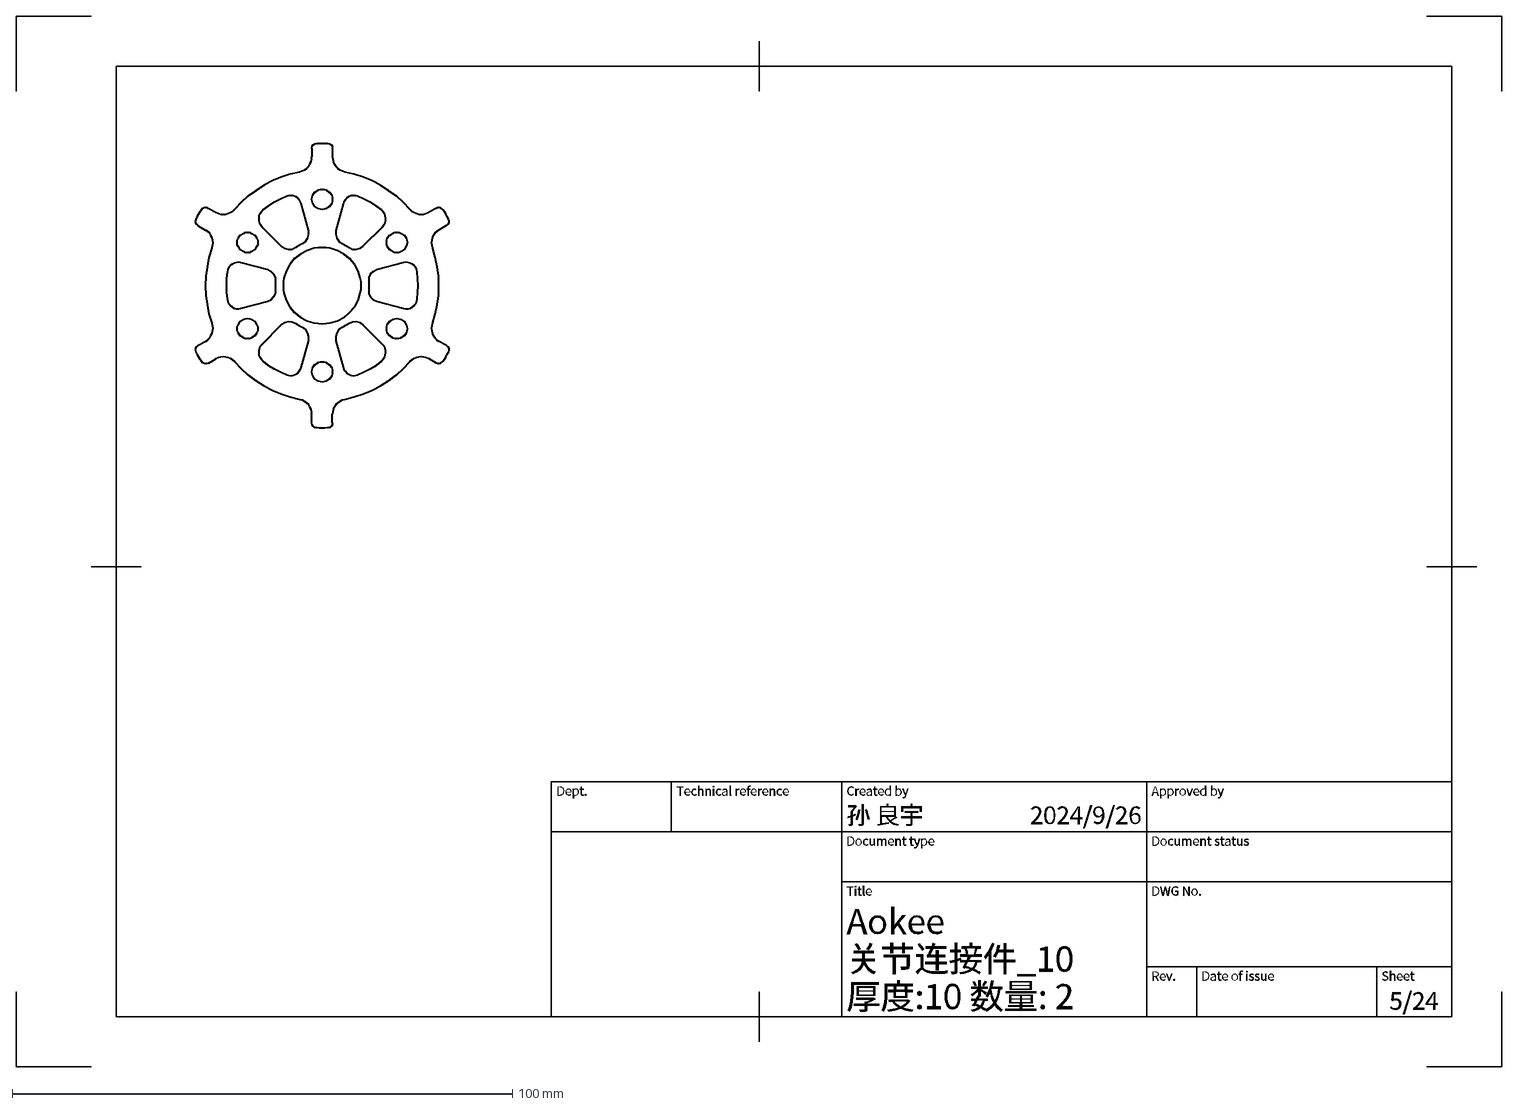
[picture p45: CAD file, 2024-09-26]
model/发加工/PL/PL_C10__关节连接件_10_厚度10_数量2.dxf
厚度:10 数量: 2
2024/9/26
5/24
关节连接件_10
Aokee
孙 良宇
Dept.
Technical reference
Created by
Approved by
Document type
Document status
Title
DWG No.
Rev.
Date of issue
Sheet
