dokee39/Aokee-sim/model/发加工/PR/PR_FDM_PLA__wheel_补差价垫板.step

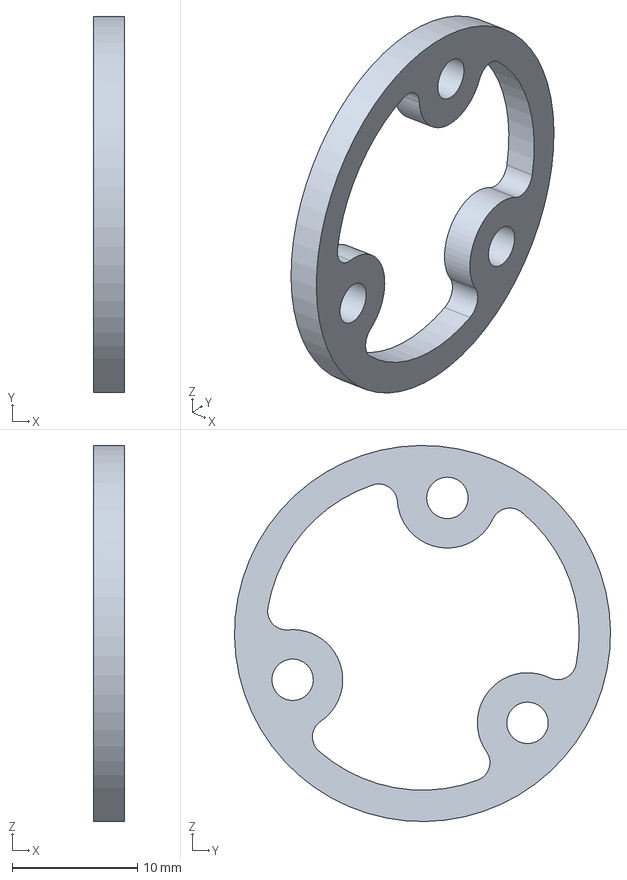
[picture p46: CAD file, 2024-09-26]
model/发加工/PR/PR_FDM_PLA__wheel_补差价垫板.step
2.50 x 30.0 x 30.0 mm
