dokee39/Aokee-sim/model/发加工/PL/PL_C10__joint_中间碳板_厚度10_数量4.dxf

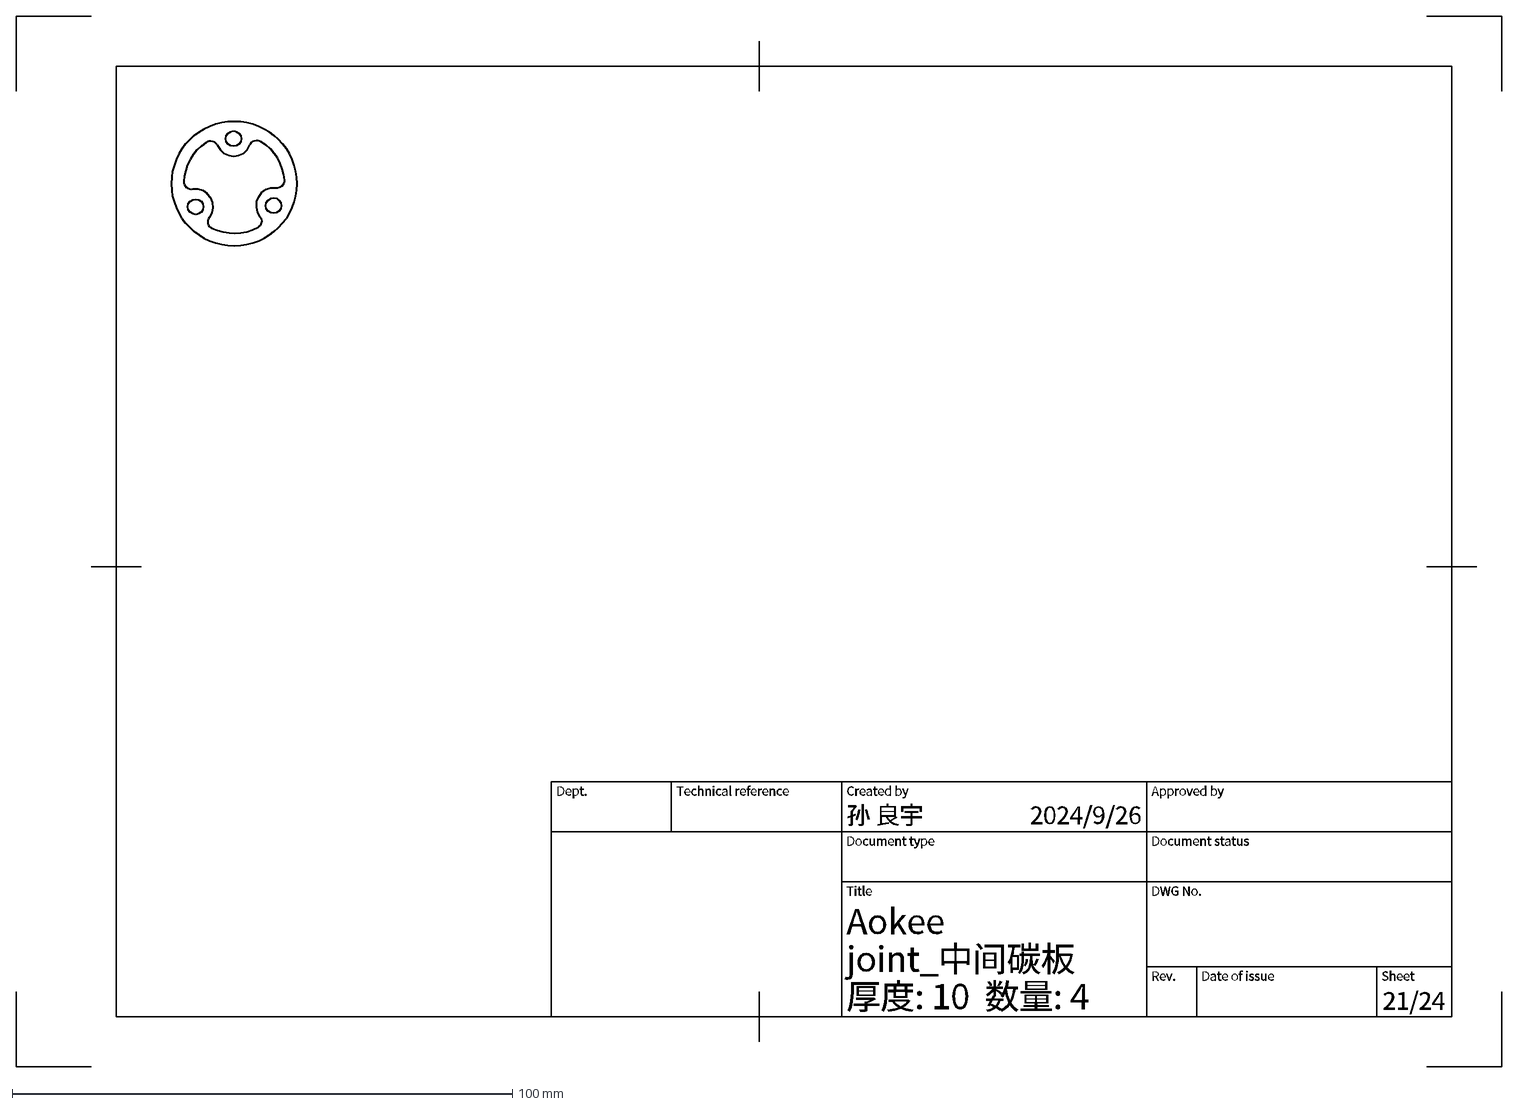
[picture p47: CAD file, 2024-09-26]
model/发加工/PL/PL_C10__joint_中间碳板_厚度10_数量4.dxf
厚度: 10 数量: 4
2024/9/26
21/24
joint_中间碳板
Aokee
孙 良宇
Dept.
Technical reference
Created by
Approved by
Document type
Document status
Title
DWG No.
Rev.
Date of issue
Sheet
