dokee39/Aokee-sim/model/发加工/PR/PR_FDM_TPU__关节限位软块.step

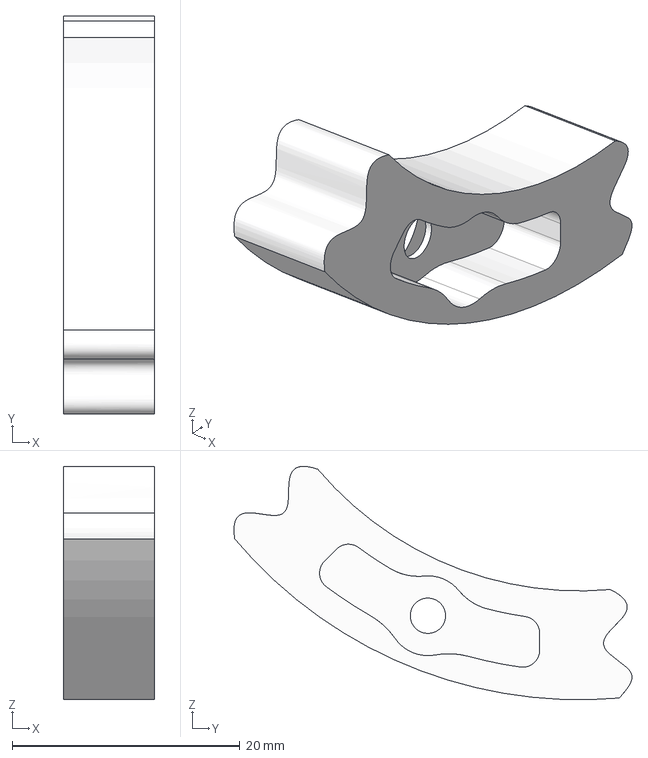
[picture p48: CAD file, 2024-09-26]
model/发加工/PR/PR_FDM_TPU__关节限位软块.step
8.00 x 34.9 x 20.5 mm
