dokee39/Aokee-sim/model/发加工/PR/PR_FDM_PLA__铝方管补强件4.step

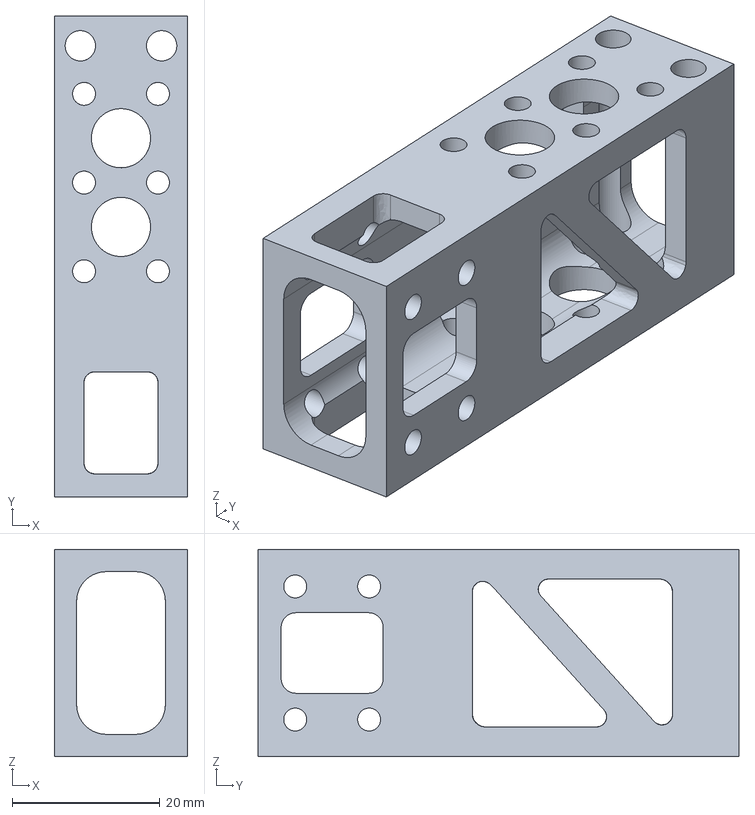
[picture p51: CAD file, 2024-09-26]
model/发加工/PR/PR_FDM_PLA__铝方管补强件4.step
18.0 x 65.0 x 28.0 mm
