dokee39/Aokee-sim/model/发加工/PL/PL_C5__frame_joint_inner_厚度5_数量2.dxf

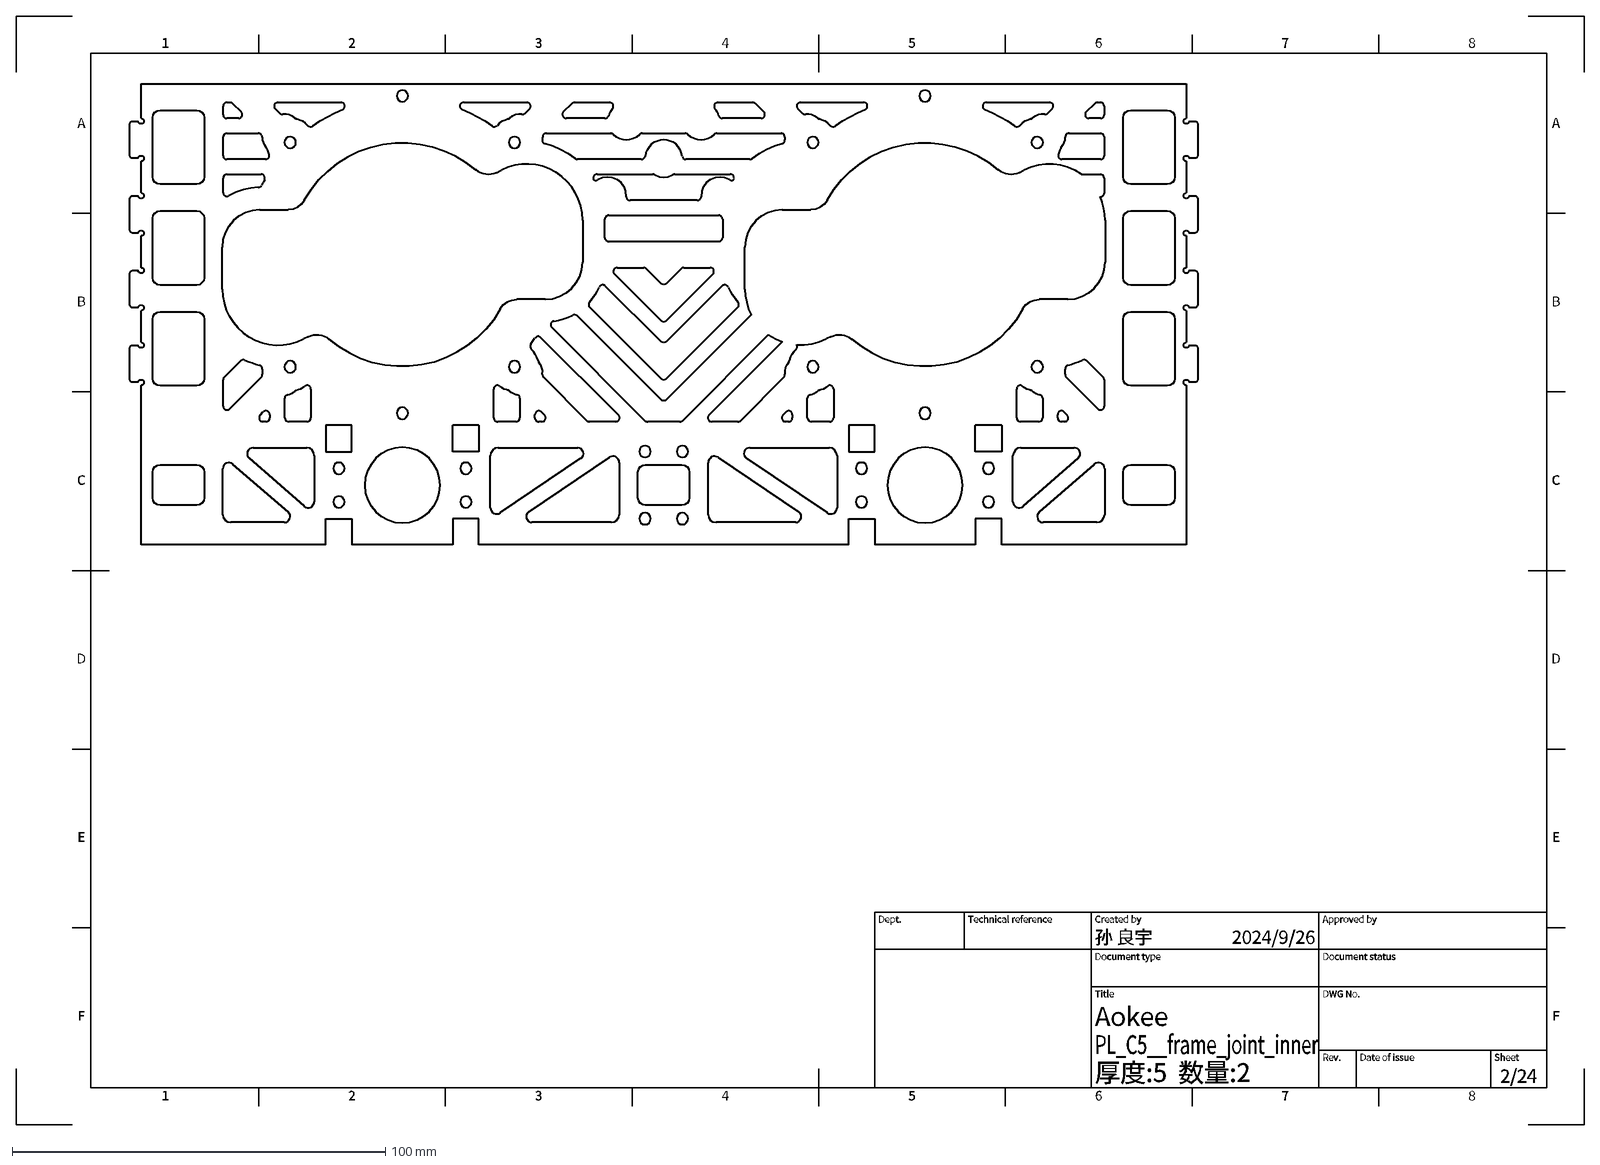
[picture p55: CAD file, 2024-09-26]
model/发加工/PL/PL_C5__frame_joint_inner_厚度5_数量2.dxf
1
A
2
3
4
5
6
7
8
B
C
D
E
F
厚度:5 数量:2
2024/9/26
2/24
PL_C5__frame_joint_inner
Aokee
孙 良宇
Dept.
Technical reference
Created by
Approved by
Document type
Document status
Title
DWG No.
Rev.
Date of issue
Sheet
