dokee39/Aokee-sim/model/发加工/PL/PL_C2__wheel_joint_厚度2_数量2.dxf

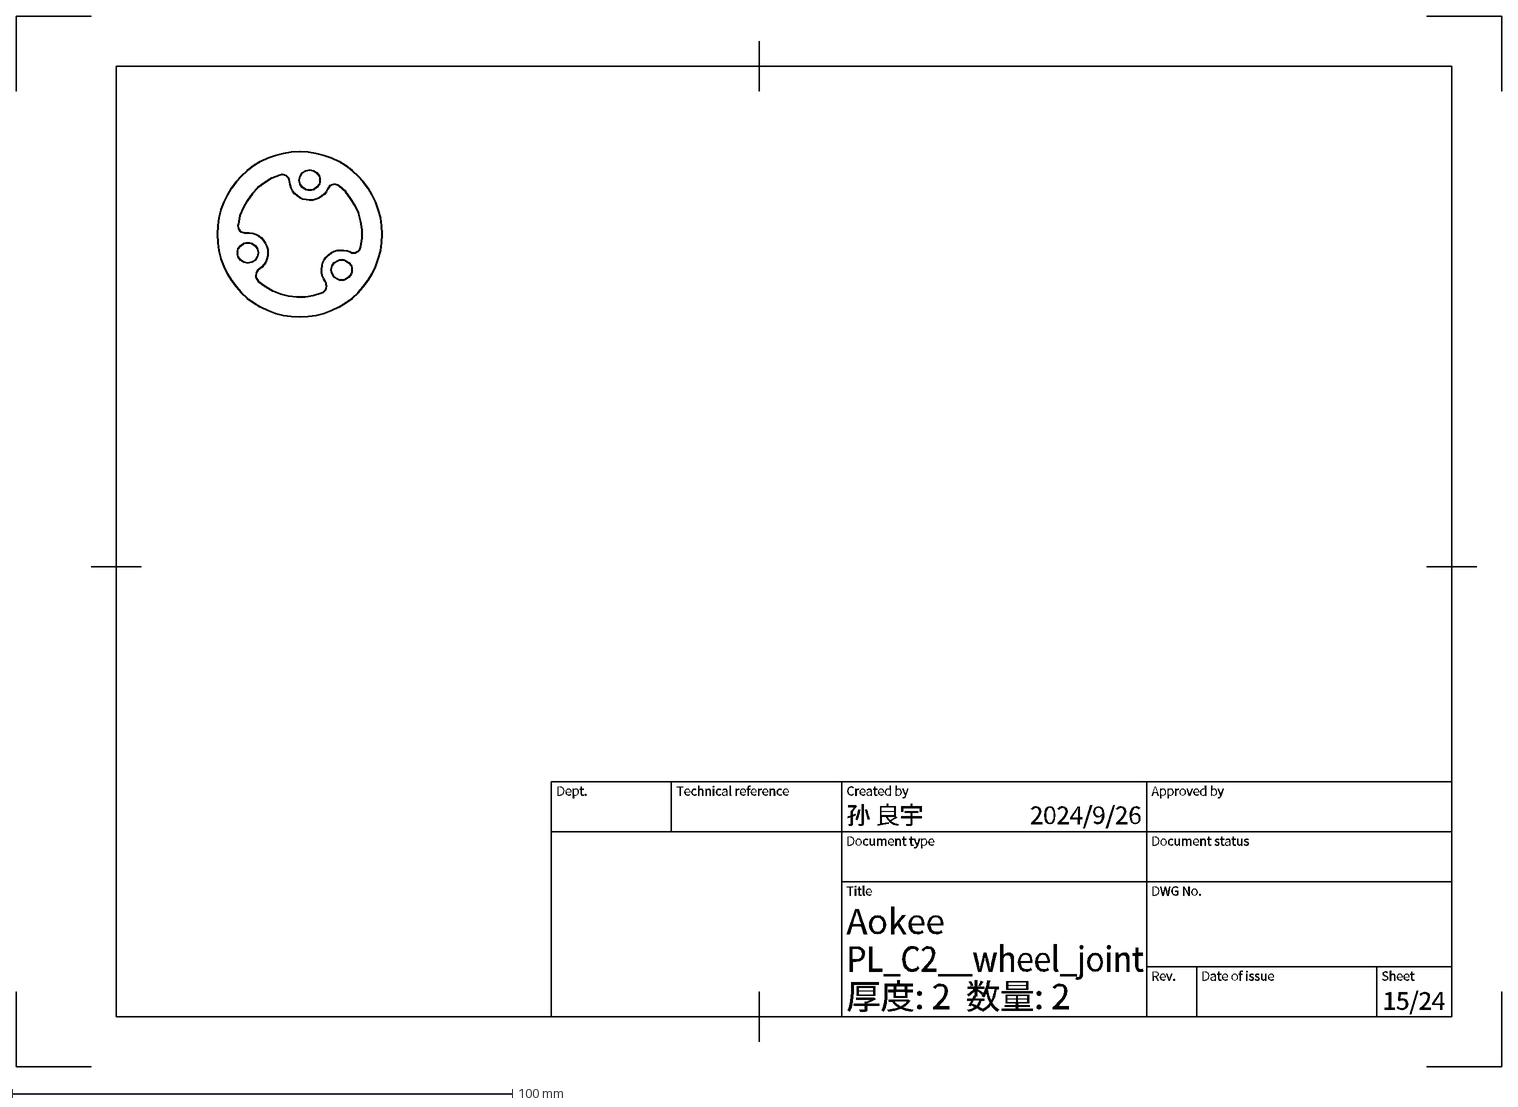
[picture p56: CAD file, 2024-09-26]
model/发加工/PL/PL_C2__wheel_joint_厚度2_数量2.dxf
厚度: 2 数量: 2
2024/9/26
15/24
PL_C2__wheel_joint
Aokee
孙 良宇
Dept.
Technical reference
Created by
Approved by
Document type
Document status
Title
DWG No.
Rev.
Date of issue
Sheet
