dokee39/Aokee-sim/model/发加工/PL/PL_C10__关节连接件_带限位_厚度10_数量4.dxf

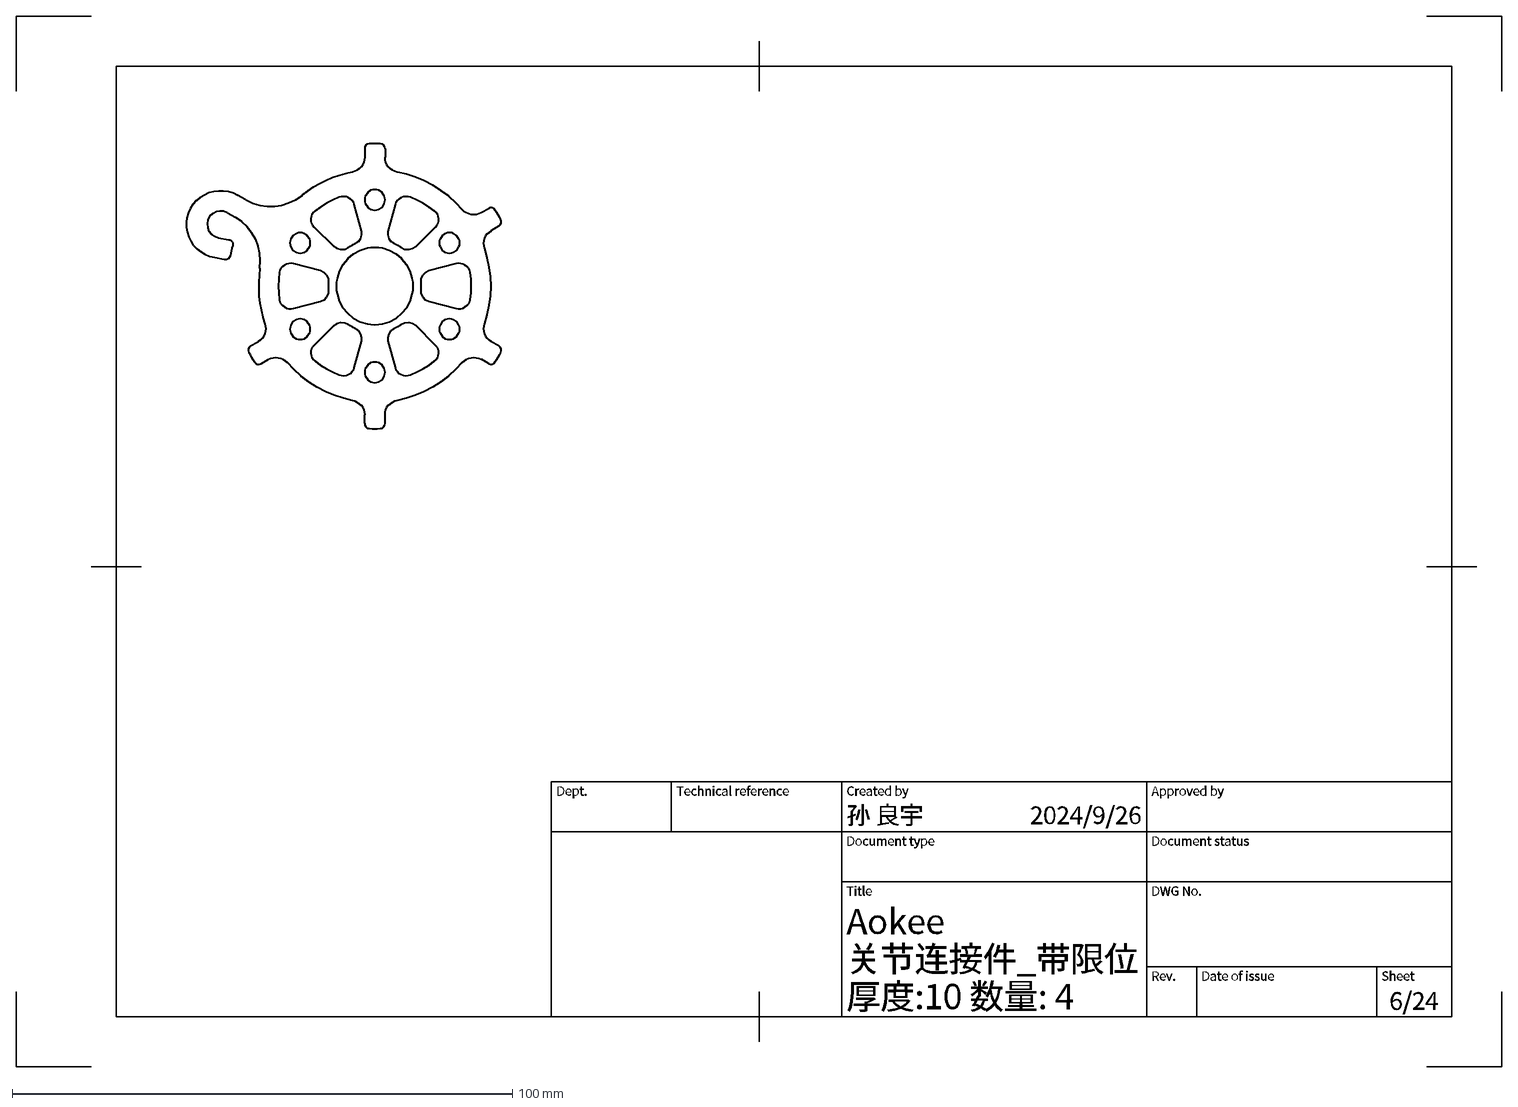
[picture p57: CAD file, 2024-09-26]
model/发加工/PL/PL_C10__关节连接件_带限位_厚度10_数量4.dxf
厚度:10 数量: 4
2024/9/26
6/24
关节连接件_带限位
Aokee
孙 良宇
Dept.
Technical reference
Created by
Approved by
Document type
Document status
Title
DWG No.
Rev.
Date of issue
Sheet
