dokee39/Aokee-sim/(list of files, cad)

Other CAD files:
model/发加工/PR/PR_FDM_PLA__铝方管补强件3_带钩子_1.step
model/发加工/CNC/CNC_A96061__关节电机固定1.step
webots/meshes/leg_low_2.STL
model/发加工/PR/PR_FDM_PLA__铝方管补强件3_1_带钩子.step
webots/meshes/leg_up_1.STL
webots/meshes/wheel2.STL
model/发加工/PR/PR_FDM_PLA__铝方管补强件3_2_带钩子.step
model/Aokee v73.f3z
