dokee39/Aokee-sim/(commit log)

2024-09-06 initial impl five_links
    [base_link.STL, leg_low_1.STL, leg_low_2.STL, leg_up_1.STL, leg_up_2.STL, wheel1.STL, wheel2.STL]
2024-09-10 ready for test leg ctrl
2024-09-11 test leg solution OK
2024-09-13 leg test OK
2024-09-19 param select & motor select
    [motor.xlsx]
2024-09-26 add 3D model
    [Aokee BOM.xlsx, CNC_A96061__frame_纵竖连接.step, CNC_A96061__joint_不带螺纹.step, CNC_A96061__joint_带螺纹.step, CNC_A96061__wheel_jonit_加工修改ver.step, CNC_A96061__关节电机固定1.step, CNC_A96061__关节电机固定2.step, CNC_A96061__前后挡板连接件.step]
2024-10-07 add LqrSim world
    [Aokee BOM.xlsx, Aokee v73.f3z, PP_A3020_1__frame_joint_竖.step, PP_A3020_1_frame_joint_竖.step, PR_FDM_PLA__装甲板底垫板.step, PR_FDM_PLA__铝方管补强件3_带钩子_1.step, PR_FDM_PLA__铝方管补强件3_带钩子_2.step, PR_FDM_PLA_装甲板底垫板.step]
